accel-kitchen/dna-accessory-console/design/preview/3d-top.png

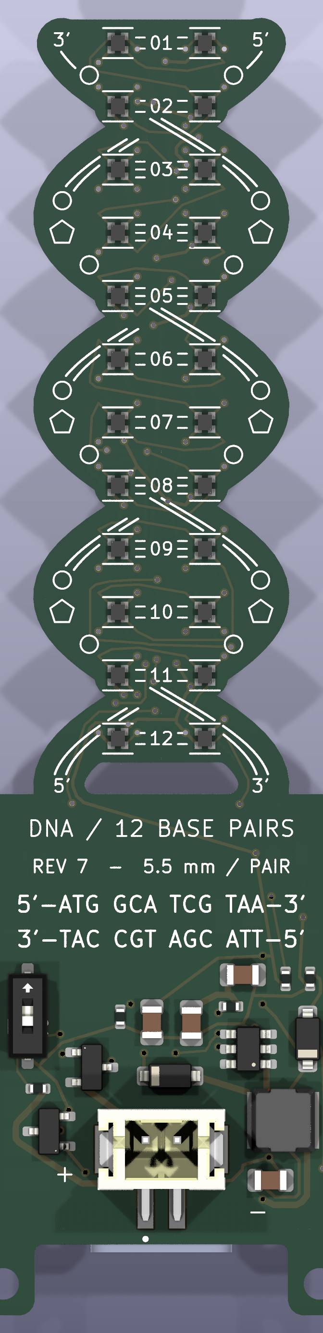
design/preview/3d-top.png
