accel-kitchen/dna-accessory-console/design/preview/3d-iso-collar-back.png

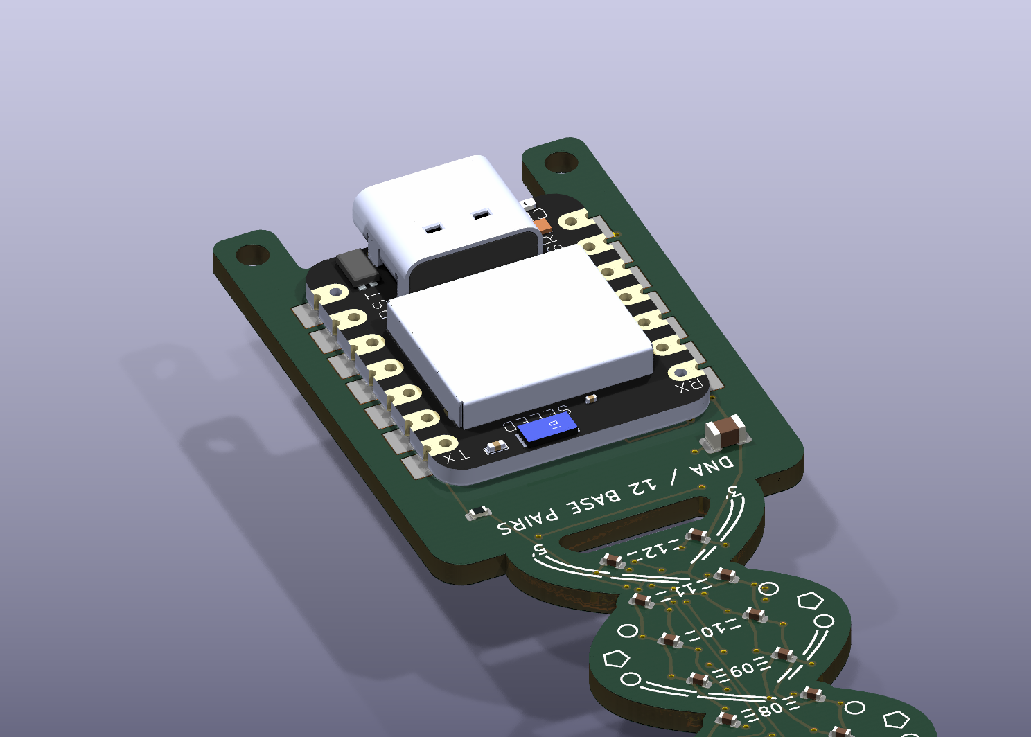
design/preview/3d-iso-collar-back.png
