accel-kitchen/dna-accessory-console/design/comparison-rev4-rev5.html

DNA / PCB — REVISION COMPARISON2026.11.05 · KiCad 9.0.4

# 旧基板より、約4割小さく。 吊り穴はマイコン側へ、 電池でも光り、 スイッチで切れる。

改訂4（配線済みの旧基板、29.0 × 116.6 mm）と改訂7（現在の基板、24.0 × 82.1 mm）を、同じ縮尺で並べて比べた資料です。 LED の並び順とデータ連鎖は変えず、外形・LED の配置・吊り穴・シルクを変え、電池でも光るように昇圧と電源切り替えの 13 部品を、電池を入り切りする電源スイッチの 3 部品とともに襟の表面に追加しました。

117 → 82 mm基板の長さ（-30%）

29 → 24 mm基板の幅（-17%）

-42%外形の面積
2,290 → 1,328 mm²

0 / 0 / 0DRC 違反・未接続・差異
新旧とも

01 / SIDE BY SIDE

## 同じ縮尺で並べる

左が旧基板、右が新基板です（表面、3D レンダリング）。らせんが短く細くなり、襟の幅が詰まり、下端に吊り穴の耳が付きました。

<b>旧</b> 改訂4 29.0 × 116.6 mm（表面）の3Dレンダリング

旧 改訂4 29.0 × 116.6 mm

→

<b>新</b> 改訂7 24.0 × 82.1 mm（表面）の3Dレンダリング

新 改訂7 24.0 × 82.1 mm

<b>旧</b> 裏面（XIAO nRF52840）（裏面）の3Dレンダリング

旧 裏面（XIAO nRF52840）

→

<b>新</b> 裏面（XIAO nRF52840）（裏面）の3Dレンダリング

新 裏面（XIAO nRF52840）

02 / OUTLINE OVERLAY

## 外形を重ねる

襟（マイコン部）の位置は同じなので、そのまま重ねられます。薄い灰色が旧、緑が新、点は LED（旧は灰色、新は黄色）です。

旧基板新基板新の LED 24 個

03 / NUMBERS

## 数値の比較

項目 | 旧（改訂4） | 新（改訂5） | 変化 | メモ
基板の幅 | 29.0 mm | 24.0 mm | -17% | マイコン部の幅を XIAO のパッドに合わせて詰めた
基板の長さ | 116.6 mm | 82.1 mm | -30% | 吊り穴の耳（4.5 mm）を含む
外形の面積 | 2,290 mm² | 1,328 mm² | -42% | 抜き穴を除いた実面積
らせん部の長さ（先端〜襟） | 88.1 mm | 49.1 mm | -44% | 旧は先端の吊り環を含む
らせんの幅 | 26.8 mm | 16.2 mm | -40% | 振幅 ×2 ＋ バックボーン幅
塩基対の LED 間隔 | 10.0 mm | 5.5 mm | -45% | 中心間。向かい合う 2 個
塩基対のピッチ | 6.5 mm | 4.0 mm | -38% | 12 対・2 回転は変わらず
バックボーン幅 / 梯子の幅 | 4.8 / 3.4 mm | 3.2 / 3.0 mm | | 梯子 3.0 mm が LED 周りのビアの限界
吊り穴 | φ3.0 mm × 1（らせん先端） | φ2.0 mm × 2（USB-C 側の耳） | | 耳の内側の間隔 16 mm
外形内の抜き穴 | 10 個 | 3 個 | | 新はらせん内の窓が消え、襟の上のスリットと吊り穴だけ
シルクの塩基文字（T/C/A/G） | 48 個 | 0 個 | | 表裏とも削除。対番号・5′3′・水素結合は残した
配線の総延長 | 1,073 mm | 846 mm | -21%
ビア | 86 個 | 107 個 | +24% | 密度が上がり、わずかに増えた
FR4 基板の重さ（概算） | 6.8 g | 3.9 g | -42% | 面積 × 1.6 mm × 1.85 g/cm³。部品・銅は含まない
部品点数 | 52 点 | 68 点 | | 新は昇圧・切り替えの 13 部品と電源スイッチの 3 部品を追加（BOM は 6 → 15 品番）
DRC（KiCad 9.0.4） | 違反 0 / 未接続 0 / 差異 0 | 違反 0 / 未接続 0 / 差異 0 | | 回路図は昇圧回路などを追加

04 / THREE CHANGES

## 変えた3点

### ① 吊り穴を、らせん先端からマイコン側へ

旧基板の先端の吊り穴

旧 らせんの先端に φ3.0 mm の穴

新基板の下端の耳と吊り穴

新 USB-C 側の下端に耳を2つ、φ2.0 mm の穴

下端の中央は USB-C の差し込み口と電池コネクタ（J1）で埋まっているため、穴は左右の耳に分けました。耳の内側の間隔は 16 mm で、USB-C のプラグはその間を通ります。 チェーンを2つの穴に通すと、USB-C 側を上にして、らせんが下に垂れます。先端の吊り環がなくなった分、らせん側も短くなりました。

### ② DNA 部分を小さく

LED 間隔を 10 mm から 5.5 mm、塩基対ピッチを 6.5 mm から 4.0 mm にし、梯子の幅を 3.4 mm から 3.0 mm に細くしました。マイコン部の幅は、XIAO のパッドが約 20 mm なので 29 mm から 24 mm まで詰めています。 配線ツールで試した限界は、ピッチ 3.8 mm で配線が収束せず、3.6 mm 以下は梯子が 2.8 mm 以下になって LED 周りのビアが入りません。

### ③ シルクの塩基文字を削除

旧基板の塩基文字つきシルク

旧 各段に T/C/A/G の文字（表裏で 48 個）

新基板のシルク

新 文字なし。対番号・水素結合・糖とリン酸の環は残す

LED の色はソフトウェアで決めるので、基板に固定の塩基文字は印刷しません。襟の配列表記（5′-ATG GCA TCG TAA-3′ など）と水素結合の本数は、そのままです。襟の表面は、昇圧部品の場所をあけるため、START/STOP と凡例 3 行を削除しました。

### ④ 電池でも光る：昇圧・電源切り替え・電源スイッチを追加

旧基板の LED の電源は XIAO の USB の 5 V だけで、電池では光りませんでした。新基板は、電池を昇圧（MT3608B で 5.0 V）して LED に供給し、USB があるときは USB を優先して自動で切り替えます（部品 13 点、襟の表面）。電池のマイナスは GND に直結し、昇圧の電流が XIAO の内部を通らないようにしました。電池は、基板上のスライドスイッチ（P-MOSFET を駆動）で入り切りでき、OFF にすると USB がないとき電池の電流は流れません（昇圧は消灯中も約 19 mA 流れるため）。詳しい確認結果は review.html にあります。

05 / NEW COLLAR

## 新しい襟まわり（3D）

襟の表面：電池コネクタ、昇圧回路、吊り穴の耳

表：電池コネクタ（J1）、電源スイッチ、昇圧回路、吊り穴の耳

襟の裏面：マイコンモジュール

裏：XIAO と USB-C。プラグは耳の間を通る

06 / UNCHANGED

## 変えていないこと

- プロジェクト設定（同一ファイル）。回路図は昇圧回路などを追加。既存の 52 部品の UUID は変更前後で一致。
- LED 24 個（12 対）、データ連鎖の順（U2 → U25）、4 コドンの区切り。console/ のピクセル順もそのまま使える。
- 既存の 52 部品の型番。配線は引き直したが、DRC は新旧とも違反 0・未接続 0・差異 0。
- 2 回転・12 塩基対のらせんの形、表裏のシルクの意匠（糖・リン酸の環、水素結合、5′/3′）。

07 / TRADE-OFFS

## 注意点

らせん内の窓（抜き穴）が消えた。ピッチを 4.0 mm にすると梯子の間が 1.0 mm で、抜きを作れません。外形のふくらみでらせんに見えますが、旧基板の「窓の開いたらせん」の見た目とは違います。

- LED が近づいたので（間隔 5.5 mm）、隣の LED の光が混ざりやすくなります。実機の見え方は未確認です。
- 耳は 4.5 mm 突き出します。USB-C のケーブルの根元（プラグ）が 16 mm より大きいと当たります。
- ビアは 86 → 107 個。配線の総延長は短くなりましたが、密度は上がっています。
- 確認したのは KiCad 上の DRC と 3D 表示までです。実機の製造・点灯・重さは未確認です。
- 発注データ（fusion/）は改訂5に合わせて再生成済みですが、Seeed Fusion への再見積・再注文はしていません。

旧：design/pre-compact-20261102/ 新：dna-accesories.kicad_pcb 生成：gen/compare_stats.py → gen/make_comparison.py
