accel-kitchen/dna-accessory-console/design/review-rev6.html

DNA / PCB — ENGINEERING REVIEW · REV. 62026.11.06 · KiCad 9.0.4

# 電池でも光る設計に。 配線と製造データは整合。

改訂6（24.0 × 82.1 mm、65 部品）は、前回（改訂5）の未解決点だった「電池だけでは LED が点灯しない」を、昇圧（MT3608B）と USB／電池の自動切り替えで解決した基板です。 KiCad の DRC・ERC に加えて、銅箔の間隔、電源の電圧降下、ネットの連鎖、部品の位置、3D 干渉、製造データを別の方法でも確かめました。

判定：回路の接続・形状・製造データに誤りは見つかりませんでした。 電池 → 昇圧（5.0 V）→ LED の経路と、USB があるときは USB を優先する切り替えは、回路・基板・配線で確認できました。 ただし、追加した昇圧回路は実機で動かしていません。確認をおすすめするのは、昇圧部品の調達（型番と在庫）、電池の仕様と電流、昇圧の GND の戻り経路（0.2 mm 幅）、吊り穴まわりの肉厚、ビアの環です。実機の製造・点灯・Fusion の受入れ確認は、まだ行っていません。

改訂6の表面

改訂6の裏面

0 / 0 / 0DRC：違反・未接続・回路図との差異
ERC は警告 3 件（下記）

0.14 mm銅箔どうしの最小間隔の実測
Fusion の下限 0.10 mm

104 mV全白（368 mA）時の最遠 LED の電源損失
昇圧出力からの往復

4.8〜5.2 V昇圧の出力電圧の範囲（公称 5.0 V）
LED の動作 2.5〜5.5 V

01 / WILL IT LIGHT?

## 「ちゃんと動くか」の判定

条件 | 判定 | 根拠と限界
USB で給電して LED を点灯 | 設計上は成立 | USB の 5 V → D2（ショットキー）→ POWER。Q1 が昇圧を止めるので電池は減らない。ダイオードの順電圧（約 0.4 V と見積り）を引いて LED は約 4.5 V。配線の損失は最遠 LED で 98 mV。実機は未確認。
電池だけで LED を点灯 | 設計上は成立 | 電池（VBAT）→ L1 → MT3608B → D1 → POWER（5.0 V）。出力電圧は帰還抵抗 110 kΩ／15 kΩ で決まり、部品の公差を入れて 4.81〜5.19 V。実機での起動・出力は未確認。
USB を抜く・挿す瞬間 | 要確認 | USB を抜くと Q1 が切れて昇圧が起動する。起動までの間は、昇圧の IC を通らず電池からインダクタとダイオード経由で LED に約 3.4 V が届く。LED が一瞬暗くなる、または再起動する可能性がある。USB を挿すと Q1 が EN を落とし、USB 経由に切り替わる。
電池をつないだまま USB で給電（充電） | 設計上は成立 | J1 → VBAT → XIAO の BAT+（ネット一致を確認）。充電は XIAO の機能で、昇圧とは別の経路。電池の極性・仕様は未確認。
XIAO D6 → 24 個の LED を順に制御 | 配線は成立 | D6 → R1（100 Ω）→ U2.DIN → … → U25 の 23 段をネットで確認。ファームウェアは未コンパイル・未書き込み（USB 給電のときだけ動く処理は削除済み）。
3.3 V の信号を LED が読めるか | 条件付き | LED 資料 p.5：VDD=5 V での入力 High は 2.8 V 以上、Low は 1.6 V 以下。XIAO の 3.3 V は上回る。昇圧の出力が 4.8 V 台でも条件は近い。実波形は未測定。
Bluetooth（BLE） | 未確認 | XIAO の周囲の銅箔・昇圧のスイッチングとアンテナの位置関係は要確認（R6-06）。コンソールは USB シリアルを使うので、LED 点灯には影響しない。
Seeed Fusion での製造・組立 | 見込みは良好 | 実測の余裕は公開仕様を満たす。ビアの環だけ規定を確認できなかった（R5-03）。昇圧部品の調達は未確認（R6-01）。Fusion の DFM 確認は未実施。

02 / FINDINGS

## 指摘

「要判断」は設計仕様の決めが必要なもの、「要確認」は実部品・製造先・実機で確かめるもの、「参考」は知っておけばよいものです。今回は要判断がなくなり、昇圧回路に関する要確認が新しく加わりました。

R6-01 ／ 要確認 ／ 改訂6で追加

### 昇圧回路は実機で動かしていない。部品の調達も未確認

追加した 13 部品（MT3608B、10 µH インダクタ、ショットキー 2 個、MOSFET、10 µF ×4、抵抗 ×4）は、データシートの標準回路（Fig.1：5 V 出力、110 kΩ／15 kΩ）に沿って選び、定格の余裕を計算しました。 入力電流の最大（全白・3.0 V の電池）は約 0.73 A で、インダクタの実効電流 1.2 A、飽和電流 1.3 A、ダイオード 1 A、MT3608B のスイッチ電流制限 4 A のいずれにも収まります。出力コンデンサは合計 30 µF（公称）で、データシートの推奨 22 µF 以上です。

確認が必要なのは次の点です。①起動・5 V 出力・切り替え・効率・発熱・ノイズは、実機で測るまで分かりません。②MT3608B の LCSC 番号、Bourns SRN4018TA-100M の LCSC 番号、抵抗（110 kΩ、15 kΩ、100 kΩ）の LCSC 番号は確認できていません（BOM のリンクは検索ページ）。Fusion が調達できない場合の代替品は fusion/BOM_detail.xlsx に書きました。③インダクタの代替（Sunlord SWPA4020S100MT）は、パッド寸法を確認してから使ってください。

根拠：MT3608B データシート Rev1.1（Aerosemi、取得日 2026-11-06）、Bourns SRN4018TA-100M の仕様（販売店の掲載値）、ネットリスト。部品の入手性は検索結果の範囲です。

R6-02 ／ 要確認 ／ 前回の指摘 07（電池の仕様）に対応

### 電池の仕様と、電池から流れる電流

全白（LED 24 個で 0.37 A、5 V）のとき、電池から流れる電流は 3.7 V で約 0.58 A、3.0 V で約 0.73 A です（昇圧の効率 85 % の仮定）。ファームウェアの明るさ上限（128/255）では約半分です。 容量 500 mAh の電池なら、全白で約 0.9 時間、上限どおりで約 1.7 時間の見積りです（概算で、実測ではありません）。容量が小さい電池（150 mAh 以下）は、全白で 4C 前後になるので避けてください。

電池は保護回路付きの 1 セル（3.7 V）を使ってください。MT3608B は入力 2.4 V 付近で止まりますが、電池の過放電を防ぐ回路は基板にありません。J1 の 1 番ピン（基板の「+」側）が電池の＋です。JST PH の電池ケーブルは売り場によって赤黒の並びが逆の場合があるので、実物の極性を確かめずにつなぐと、XIAO や電池を壊すことがあります。

R6-03 ／ 要確認 ／ 改訂6で追加

### 昇圧の GND の戻り経路が 0.2 mm 幅で、許容電流に近い

基板には GND の面（ベタ）がなく、GND は 0.2 mm 幅の配線です。昇圧の入力電流が電池へ戻る経路は、全白・3.0 V の電池で最大 0.73 A が、幅 0.2 mm の銅箔を通ります。同じ幅の外層の許容電流は、温度上昇 10 K で約 0.74 A（IPC-2221）で、ほぼ同じ値です。 ファームウェアの明るさ上限（128/255）では約 0.36 A、3.7 V の電池の全白でも約 0.58 A なので、実用上は余裕がありますが、全白を長く続けるとこの経路が温まります。

昇圧の大電流の線（VBAT、SW）は 0.4 mm 幅で引きました（VBAT の最大電流 0.73 A）。スイッチ端子（SW）の配線は 4.4 mm と短くまとまっています。 改善案：GND を 0.4 mm 以上にする、または襟の部分に GND の銅箔（ベタ）を追加する。データシートも「強い GND 面」を勧めています。

R6-04 ／ 参考 ／ 前提の確認

### 電池のマイナス（BAT−）を GND に直結した

昇圧の入力電流を XIAO の内部経由で戻さないため、J1 の 2 番ピンと XIAO の BAT−パッドを、基板上で GND につなぎました。Seeed の XIAO nRF52840 回路図（v1.1）では、電池は VBAT と GND だけで、BAT− は GND そのものです。この前提は回路図で確認しましたが、実物のモジュールでの導通は測っていません。 ERC は、電池の＋と電源フラグ、BAT− と GND の端子の型の組み合わせについて警告を出します（意図した接続です）。

R5-02 ／ 要確認 ／ 改訂5で生じた点

### 吊り穴まわりの肉厚が 1.0 mm

吊り穴は φ2.0 mm の穴 2 つで、耳（幅 4 mm、先端 y=150.5 mm）の穴の縁から外形までが 0.98 mm です（FR4 厚 1.6 mm）。改訂4の穴（φ3.0 mm）は先端の周りが約 2.1 mm ありました。

概算：ペンダントを約 10 g、動いたときの衝撃を 10 倍（1 N）とし、耳の先端がちぎれる面（穴の縁から外形まで 1.0 mm、2 面、厚 1.6 mm の合計 3.2 mm²）に FR4 のせん断強度を 40 MPa（一般的な値の仮定）とすると、耐えられる力は約 130 N で、安全率は約 100 です。静的な強度は足りる見積りですが、 金属のチェーンや指輪で縁がこすれて削れる、落とした衝撃で耳が欠ける、といった使い方の面では余裕が小さい部分です。気になる場合は、耳を 6 mm 幅にして穴の縁から 1.5 mm 以上取る方法があります。

根拠：外形データ（design/dna-geometry.json）からの実測。強度は概算で、実物の試験はありません。穴の円は外形層の 128 角形で出力されます（Fusion の DFM で問題にならないか、発注時に確認してください）。

R5-03 ／ 要確認 ／ 製造

### ビアの環が 0.13 mm

ビアはパッド 0.56 mm・穴 0.30 mm で、環（穴の縁からパッドの縁まで）は 0.13 mm、91 個すべて同じです。Seeed Fusion の公開ページ（製造仕様の wiki・製品ページ）では、最小穴径 0.2 mm は読み取れましたが、環やビアのパッド径の規定は見つかりませんでした。 古い資料に 0.15 mm 以上という記載があるという情報もありますが、現行の値とは確認できていません。

対応：発注時に Fusion の DFM 確認を受けてください。0.15 mm が必要と言われた場合は、ビアのパッドを 0.60 mm にして配線をやり直します（ルーターの設定 VIAD と gen/route_apply.py のビア径を変えて再配線します。ただし、間隔の余裕は減ります）。

R6-06 ／ 参考（前回の R5-05 を更新）

### XIAO のアンテナ側に配線の銅箔と昇圧回路がある

XIAO の上端（らせんに向く側、モジュールの端は y=124 mm）を含む帯（x 90〜110、y 121〜129 mm）に、41 mm 分の配線があります。さらに、昇圧回路は襟の表面（y 127〜141 mm）にあり、1.2 MHz で動くスイッチ部（インダクタとダイオード）はアンテナ側の端（y=124 mm）から約 4〜11 mm の位置です（L1 の端が 4 mm、D1 が 8 mm）。 アンテナの位置と銅箔の禁止範囲は Seeed の資料で確認していません。BLE を使うときは、昇圧が動いている状態で通信距離を実測してください。

R6-07 ／ 参考

### シルク・LED 間隔・USB の電流

- 襟のシルクは、昇圧部品の場所をあけるため、START/STOP と凡例 3 行（A=T 2 BONDS…、2 TURNS…、WATSON CRICK…）を削除し、REV の表記を「REV 6」にしました。「+」「−」は J1 のそばに移しました。
- LED の枠線 8 本の端が、外形に 0.08〜0.2 mm まで近づいています（DRC は警告扱い）。製造の外形の公差（±0.2 mm）で、端がわずかに欠ける可能性があります。
- LED 間隔が 5.5 mm なので、隣の LED の光が混ざりやすくなります。らせん内の窓は消えて、襟の上のスリットだけです。
- USB で給電するときは、LED 全白の 0.37 A に XIAO と電池の充電（最大 100 mA）が加わり、約 0.48 A で USB の 0.5 A に近づきます。ファームウェアの明るさ上限（128/255）では約 0.19 A です。

R6-08 ／ 参考 ／ 資料の食い違い（今回修正）

### 文書の更新

- 旧 review.html（改訂5）は design/review-rev5.html に、さらに前のレビューは design/review-rev3-rev4.html にあります。
- lp/（試作ページ）、console/README.md、2 つのファームウェアの冒頭、fusion/README.md、design/README.md を、電池でも光る構成に合わせて更新しました。

03 / CARRY-OVER

## 前回（改訂3）の指摘 01〜09 の結果

前回の指摘 | 現在 | 根拠
01 LED の VDD と DOUT が逆 | 解決 | パッド 1=DOUT（左上）、2=VDD（右上）、3=GND（左下）、4=DIN（右下）。LED 資料 p.10 の上面図と一致。パッドの機能（ネット）は全 24 個で確認。座標は U2・U3 で確認（全 LED が同じフットプリントで、向きは 0°/180° のみ）。
02 電源・GND・24 段の信号を配線 | 解決 | DRC 未接続 0。ネットの連鎖を基板上で確認（下の一覧）。
03 電池単独の LED 給電 | 解決（設計・実装） | 昇圧（MT3608B）と USB／電池の自動切り替えを追加。実機は未確認（R6-01）。
04 LED 近傍のコンデンサ | 解決 | C1〜C24（100 nF）が各 LED の真裏、C25（10 µF）が入口。LED のパッド〜コンデンサ間の銅箔の長さは平均 3.9 mm、最大 4.6 mm（GND 側 最大 4.0 mm）。
05 3.3 V の信号 | 条件付き | 100 Ω の直列抵抗 R1 を実装。しきい値は満たす見込み。実波形は未測定。
06 ファームウェア | コードあり・未検証 | D6・24 個・GRB・明るさ上限 128。電池でも動くよう、USB 給電のときだけ動く処理を削除。未コンパイル・未書き込み。
07 XIAO 裏面実装と電池 | 一部 | U1 は裏面の底面パッドで実装する前提。電池の仕様と極性は → R6-02。
08 ERC と製造ルール | 一部 | ERC は警告 3 件（ラベル 1、端子の型の組み合わせ 2）。DRC の規則は最小間隔・最小線幅が 0 のままだが、実測と Fusion 公開仕様を比較して余裕を確認した（下の表）。
09 USB-C プラグの干渉 | 解決 | USB-C の差込口は y=146.51 mm で基板端（146.0）より外。プラグ外形（規格上限 12.35 × 6.5 mm）と基板の重なり 0.0 mm³。耳の内側の間隔 16 mm、片側の余裕 1.83 mm。

04 / MEASUREMENTS

## 製造に対する余裕の実測

DRC の規則が 0 のままだと「違反 0」は余裕を表しません。そこで、一時的に厳しい規則（間隔 1.0 mm 以上など）を KiCad に与え、違反の「実測値」の最小を集めました。Fusion の値は 2026-11-06 に公式ページ（製造仕様の wiki、製品ページ）で読んだものです。

項目 | この基板の実測 | Fusion の公開仕様 | 余裕 | 判定
銅箔どうしの最小間隔（別ネット） | 0.143 mm | 0.102 mm（4 mil） | 約1.4倍 | 余裕あり
最小線幅（信号／電源・GND／昇圧の大電流） | 0.15 ／ 0.20 ／ 0.40 mm | 0.102 mm（4 mil） | 約1.5倍以上 | 余裕あり
銅箔〜基板外形（穴を含む） | 0.560 mm | 0.3 mm 以上（このプロジェクトの規則は 0.5 mm） | 約1.9倍 | 余裕あり
LED パッドの間（ソルダーマスクのダム） | 0.39 mm | 0.32 mm 以上（緑・通常）／0.35 mm 以上（他色） | 1.1〜1.2倍 | 足りる
ビア（パッド／穴／環） | 0.56 ／ 0.30 ／ 0.13 mm | 最小穴 0.2 mm。環・パッド径の規定は公開ページで確認できず | — | 要確認
ビア穴の縁どうし／穴〜銅箔 | 0.29 ／ 0.273 mm | 規定は公開ページで確認できず（このプロジェクトの規則は 0.25 mm） | — | 要確認
シルク（線幅／文字高さ） | 0.12〜0.15 ／ 0.8 mm | 線幅 0.10 mm（4 mil）以上、文字高さ 0.58 mm（23 mil）以上 | 約1.2〜1.4倍 | 足りる
外形内の穴・抜き（吊り穴φ2.0 mm、襟上のスリット） | 最小幅 2.0 mm | 非メッキのスロット 0.8 mm 以上 | 2.5倍 | 余裕あり
基板サイズ | 24.0 × 82.1 mm | 10 × 10 〜 500 × 500 mm | — | 範囲内

ビアは表裏とも被覆（テンティング）の設定です。外形の穴は 128 角形の外形線で出力されます。製造先の最終確認は、発注時の Fusion の DFM 確認によります。

05 / POWER

## 電源

### LED までの電圧降下（基板の銅箔から計算）

基板の実際のトラックとビアから抵抗網を作り（銅 35 µm、0.49 mΩ/□、ビア 1.1 mΩ）、電源の出口（電池動作は D1 のカソードと昇圧の GND、USB 動作は D2 のカソードと XIAO の GND）から各 LED のパッドまでの電位差を計算しました。LED は定電流（R・G・B 各 5 mA）なので、全白でも 1 個あたり約 15.35 mA です。

負荷 | 動作 | 電源側の最大降下 | GND 側の最大上昇 | 最も損失の大きい LED（U3）
全白 15.35 mA／個（368 mA） | 電池 | 45 mV | 59 mV | 104 mV
全白 15.35 mA／個（368 mA） | USB | 44 mV | 55 mV | 98 mV
2 倍の余裕 30 mA／個（720 mA） | 電池 | 89 mV | 115 mV | 202 mV

### 電池から昇圧までの経路

電池の電圧 | 電池から流れる電流（概算） | 電池 → インダクタ（VBAT）の降下 | 昇圧の GND → 電池の降下
3.7 V | 0.58 A | 10 mV | 19 mV
3.0 V（空に近い） | 0.73 A | 13 mV | 24 mV

- LED の動作電圧は 2.5〜5.5 V（資料 p.5）。昇圧の出力は 4.81〜5.19 V、配線の損失は 0.1〜0.2 V なので問題ありません（USB 動作では D2 の順電圧で約 4.5 V）。この昇圧は、電池の電圧が下がっても 5 V 近くを保つので、LED の色（A/T/G/C の識別色）が電池の残量で変わりません。
- 各配線の最大電流：電源の本線 0.37 A（幅 0.2 mm）、LED の GND 戻り 0.37 A（幅 0.2 mm）、電池〜インダクタ 0.73 A（幅 0.4 mm）、昇圧の GND 戻り 0.73 A（幅 0.2 mm → R6-03）。0.2 mm 幅の許容電流は約 0.74 A（10 K 上昇、IPC-2221）。
- この計算は直流で、銅箔の温度・接触抵抗・昇圧のスイッチング（1.2 MHz）の影響・XIAO の USB 5 V 経路の降下は含みません。実機の測定が必要です。

06 / NETS & FILES

## ネット・部品・製造データの整合

### 基板上のネットの確認（KiCad の基板データから）

- ✔ R1.2 -> U2.DIN
- ✔ U1.D6 -> R1.1
- ✔ U(n).DOUT -> U(n+1).DIN, 23 hops
- ✔ U25.DOUT unconnected (CODON_END)
- ✔ every LED pad 2 = POWER, pad 3 = GND
- ✔ C(n-1) POWER/GND under U(n), same centre, back side
- ✔ POWER pads = 54: 24 LED VDD + C1-C25, C27, C29 + D1.K, D2.K, R2.1 (U1 is not on it)
- ✔ GND pads = 60: 24 LED + C1-C29 + U1 GND/BAT-, J1.2, U26, Q1.S, R3, R5
- ✔ VUSB = U1.VUSB, D2.A, Q1.G, R5.1
- ✔ VBAT = J1.1, U1.BAT+, U26.IN, L1.1, R4.1, C26.1, C28.1
- ✔ SW = U26.SW, L1.2, D1.A
- ✔ BOOST_EN = U26.EN, Q1.D, R4.2
- ✔ FB = U26.FB, R2.2, R3.1
- ✔ feedback divider R2 110k / R3 15k: output = 0.6 V x (1 + R2/R3) = 5.00 V
- ✔ every footprint value matches the schematic part (U26 MT3608B, L1 10uH, D1/D2 1N5819HW, Q1 2N7002)
- ✔ battery return: J1.2 and U1.BAT- are on GND (BAT- is the XIAO GND)
- ✔ U1 is not connected to POWER (LED power only through D1 / D2)

### 改訂5から変えたこと・変えていないこと

- 追加：昇圧と電源切り替えの 13 部品（表面の襟）、電池のマイナスの GND 直結、シルクの整理。
- 変えていない：らせんの形（24.0 × 82.09 mm）、LED 24 個とコンデンサ 24 個の位置・向き・面、U1・J1・R1・C25 の位置、LED のデータ連鎖（U2 → U25）。
- 回路図を更新（部品 13 点とネットの追加、U1.VUSB のネット名を POWER から VUSB へ、電池の＋を VBAT へ）。部品の UUID は、既存の 52 個で変更なし。

### 製造データ（fusion/）

- ガーバー・ドリル・実装座標を現在の基板から作り直した。外形サイズ 24.05 × 82.14 mm（ガーバーのジョブ情報）。
- ドリルは φ0.30 mm のみで 91 箇所＝基板のビアの数と一致。穴あけ（NPTH）はなし。
- BOM は 13 行・65 点、実装座標は 65 行で、基板の座標・面と 0.01 mm 以内で一致（不一致 0 件）。実装図に昇圧部の拡大図（Detail E）を追加。
- コンソールの LED 座標（console/board-data.js）は base-pairs.csv と一致。

### 3D 干渉

- 全 65 部品の STEP で、部品どうし・部品と基板の衝突は 0 件。
- XIAO の USB-C の口は基板端から 0.51 mm 外。USB-C プラグの外形（規格上限）と基板（耳を含む）の重なりは 0。

07 / NOT VERIFIED

## 確認していないこと

- 昇圧回路の動作（起動、5 V の出力、負荷変動、USB の抜き差しでの切り替え、効率、発熱、スイッチングのノイズ）。
- 実際の基板の製造、はんだ付け、通電、LED の点灯、温度、電池での持続時間、BLE の通信距離、ペンダントとしての重さ・つり合い。
- ファームウェアのコンパイル、書き込み、コンソールとの実機接続。
- 昇圧部品の調達（MT3608B、インダクタ、抵抗の LCSC 番号と在庫）と、インダクタ代替品のパッド寸法。
- Seeed Fusion の DFM 確認・見積・受入れ（ビアの環、穴・ビアの間隔、組立の部品間隔、基準マーク、XIAO を裏面に実装する工程は、公開ページで規定を確認できませんでした）。
- XIAO の底面パッド・アンテナ・充電の仕様の最新版との照合（Seeed の回路図は v1.1 を使用）。BAT− が GND であることの実物での導通確認。
- LED の最大定格・実際の購入ロットの仕様（資料は XINGLIGHT の公開データシート）。
- 耳の強度は概算で、実物の引っ張りや衝撃の試験はありません。

測定・生成：gen/review_checks.py（抵抗網・ネット・位置）、gen/check_interference.py（3D 干渉）、厳しい規則の DRC（gen/_runs/strict_summary.json）、gen/make_review.py。 旧レビュー：design/review-rev5.html、design/review-rev3-rev4.html 比較資料：design/comparison-rev4-rev5.html Fusion 公開仕様：seeedstudio.com の製造仕様 wiki と Fusion PCB のページ。 MT3608B：Aerosemi データシート Rev1.1。
