accel-kitchen/dna-accessory-console/design/revision-01/review.html

DNA / PCB · LAYOUT REVISION 01 · 2026.10.08

# 2本の鎖、12組の塩基対。

1個のLEDを1個の塩基として、24個を左右の鎖に12対で配置しました。各対は連続するLED番号でつながり、交差位置では鎖とLEDの左右が入れ替わります。

書き込み確認：成功 — 作成・読み戻し・削除を確認してから元設計をバックアップし、主PCBファイルを更新しました。

実座標に基づく配置図。LEDの黄／青は鎖の識別用で、塩基種・発光色の指定ではありません。XIAOは裏面です。実際のシルクはKiCad出力図を参照。

12塩基対

24RGB LED

29×117外形寸法 / 約mm

## 変更した形状と配置

- 外形を2本のらせん状の鎖と12本の塩基対の横棒で構成する、連続した1枚の基板へ再設計。
- 横棒の両端に1個ずつLEDを配置し、U2/U3からU24/U25まで12組に対応。
- LED間隔をらせんの投影形状に合わせて変化させ、鎖の交差に沿って左右を反転。
- 下端に裏面のXIAOと表面のJ1をまとめ、上端に直径3 mmの吊り下げ穴を追加。
- 小さな切抜き片を除き、内部スロットの角を約0.6 mm半径で丸める。
- LED番号は組立図に、塩基対番号01〜12は基板シルクに記載。

装飾用の2回転モデルです。塩基対数／1回転の比率や寸法は分子スケールを再現していません。

## 回路図との対応

U1.D6 → U2 → U3 → … → U25
部品UUID、パッド番号、全ネット名を維持しています。各ペア内のDOUT→DINを12本配線済みです。3対＝6個のLEDが元のCODON区分1組に対応します。

対 | 鎖A | 鎖B | 区分 | Y / mm
01 | U2 | U3 | 1 | 40.0
02 | U4 | U5 | 1 | 46.5
03 | U6 | U7 | 1 | 53.0
04 | U8 | U9 | 2 | 59.5
05 | U10 | U11 | 2 | 66.0
06 | U12 | U13 | 2 | 72.5
07 | U14 | U15 | 3 | 79.0
08 | U16 | U17 | 3 | 85.5
09 | U18 | U19 | 3 | 92.0
10 | U20 | U21 | 4 | 98.5
11 | U22 | U23 | 4 | 105.0
12 | U24 | U25 | 4 | 111.5

## 配置段階の検証

- KiCad 9.0.4：外形、銅箔と基板端、シルク、ライブラリ一致等の違反 0件。
- 回路図との対応差異 0件。
- 全26個のフットプリントとパッドネットの対応を更新前後で比較。
- 基板外のLED配置を解消し、単一外周と内部切抜きに整理。

この版は外形・配置の改訂版です。
未接続は62件あります。電源・GND、対と対の間、XIAO・電池端子の配線は次工程です。電池単独でのLED給電、デカップリング、採用LEDの1番／2番端子対応は前回のレビューから継続する設計課題で、今回の配置変更では解決していません。製造・点灯試験用の完成版ではありません。

## 設計ファイル

KiCad PCB回路図表面のKiCad出力裏面のKiCad出力塩基対一覧DRC結果改訂前レビュー

元ファイルのバックアップ：design/pre-redesign-20261008/ · 再生成用スクリプト：gen/ · 最小幅・厚さ・材質・色等の製造条件は別途確定。
