accel-kitchen/dna-accessory-console/design/base-pairs.csv

pair | group | strand | base | reference | x_mm | y_mm | rotation_deg | DIN | DOUT
1 | 1 | A | A | U2 | 102.75 | 70.0 | 180 | DIN_FIRST | Net-(U2-DOUT)
1 | 1 | B | T | U3 | 97.25 | 70.0 | 0 | Net-(U2-DOUT) | Net-(U3-DOUT)
2 | 1 | A | T | U4 | 102.75 | 74.0 | 180 | Net-(U3-DOUT) | Net-(U4-DOUT)
2 | 1 | B | A | U5 | 97.25 | 74.0 | 0 | Net-(U4-DOUT) | Net-(U5-DOUT)
3 | 1 | A | G | U6 | 97.25 | 78.0 | 0 | Net-(U5-DOUT) | Net-(U6-DOUT)
3 | 1 | B | C | U7 | 102.75 | 78.0 | 180 | Net-(U6-DOUT) | CODON2
4 | 2 | A | G | U8 | 97.25 | 82.0 | 0 | CODON2 | Net-(U8-DOUT)
4 | 2 | B | C | U9 | 102.75 | 82.0 | 180 | Net-(U8-DOUT) | Net-(U10-DIN)
5 | 2 | A | C | U10 | 97.25 | 86.0 | 0 | Net-(U10-DIN) | Net-(U10-DOUT)
5 | 2 | B | G | U11 | 102.75 | 86.0 | 180 | Net-(U10-DOUT) | Net-(U11-DOUT)
6 | 2 | A | A | U12 | 102.75 | 90.0 | 180 | Net-(U11-DOUT) | Net-(U12-DOUT)
6 | 2 | B | T | U13 | 97.25 | 90.0 | 0 | Net-(U12-DOUT) | CODON3
7 | 3 | A | T | U14 | 102.75 | 94.0 | 180 | CODON3 | Net-(U14-DOUT)
7 | 3 | B | A | U15 | 97.25 | 94.0 | 0 | Net-(U14-DOUT) | Net-(U15-DOUT)
8 | 3 | A | C | U16 | 102.75 | 98.0 | 180 | Net-(U15-DOUT) | Net-(U16-DOUT)
8 | 3 | B | G | U17 | 97.25 | 98.0 | 0 | Net-(U16-DOUT) | Net-(U17-DOUT)
9 | 3 | A | G | U18 | 97.25 | 102.0 | 0 | Net-(U17-DOUT) | Net-(U18-DOUT)
9 | 3 | B | C | U19 | 102.75 | 102.0 | 180 | Net-(U18-DOUT) | CODON4
10 | 4 | A | T | U20 | 97.25 | 106.0 | 0 | CODON4 | Net-(U20-DOUT)
10 | 4 | B | A | U21 | 102.75 | 106.0 | 180 | Net-(U20-DOUT) | Net-(U21-DOUT)
11 | 4 | A | A | U22 | 97.25 | 110.0 | 0 | Net-(U21-DOUT) | Net-(U22-DOUT)
11 | 4 | B | T | U23 | 102.75 | 110.0 | 180 | Net-(U22-DOUT) | Net-(U23-DOUT)
12 | 4 | A | A | U24 | 102.75 | 114.0 | 180 | Net-(U23-DOUT) | Net-(U24-DOUT)
12 | 4 | B | T | U25 | 97.25 | 114.0 | 0 | Net-(U24-DOUT) | CODON_END
