accel-kitchen/dna-accessory-console/design/revision-01/base-pairs.csv

pair | group | strand | reference | x_mm | y_mm | rotation_deg | DIN | DOUT
1 | 1 | A | U2 | 110.62518 | 40.0 | 180 | CODON_START | Net-(U2-DOUT)
1 | 1 | B | U3 | 89.37482 | 40.0 | 0 | Net-(U2-DOUT) | Net-(U3-DOUT)
2 | 1 | A | U4 | 102.84701 | 46.5 | 180 | Net-(U3-DOUT) | Net-(U4-DOUT)
2 | 1 | B | U5 | 97.15299 | 46.5 | 0 | Net-(U4-DOUT) | Net-(U5-DOUT)
3 | 1 | A | U6 | 92.22183 | 53.0 | 0 | Net-(U5-DOUT) | Net-(U6-DOUT)
3 | 1 | B | U7 | 107.77817 | 53.0 | 180 | Net-(U6-DOUT) | CODON2
4 | 2 | A | U8 | 89.37482 | 59.5 | 0 | CODON2 | Net-(U8-DOUT)
4 | 2 | B | U9 | 110.62518 | 59.5 | 180 | Net-(U8-DOUT) | Net-(U10-DIN)
5 | 2 | A | U10 | 97.15299 | 66.0 | 0 | Net-(U10-DIN) | Net-(U10-DOUT)
5 | 2 | B | U11 | 102.84701 | 66.0 | 180 | Net-(U10-DOUT) | Net-(U11-DOUT)
6 | 2 | A | U12 | 107.77817 | 72.5 | 180 | Net-(U11-DOUT) | Net-(U12-DOUT)
6 | 2 | B | U13 | 92.22183 | 72.5 | 0 | Net-(U12-DOUT) | CODON3
7 | 3 | A | U14 | 110.62518 | 79.0 | 180 | CODON3 | Net-(U14-DOUT)
7 | 3 | B | U15 | 89.37482 | 79.0 | 0 | Net-(U14-DOUT) | Net-(U15-DOUT)
8 | 3 | A | U16 | 102.84701 | 85.5 | 180 | Net-(U15-DOUT) | Net-(U16-DOUT)
8 | 3 | B | U17 | 97.15299 | 85.5 | 0 | Net-(U16-DOUT) | Net-(U17-DOUT)
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
