accel-kitchen/dna-accessory-console/design/functional-review/review-desktop-top.png

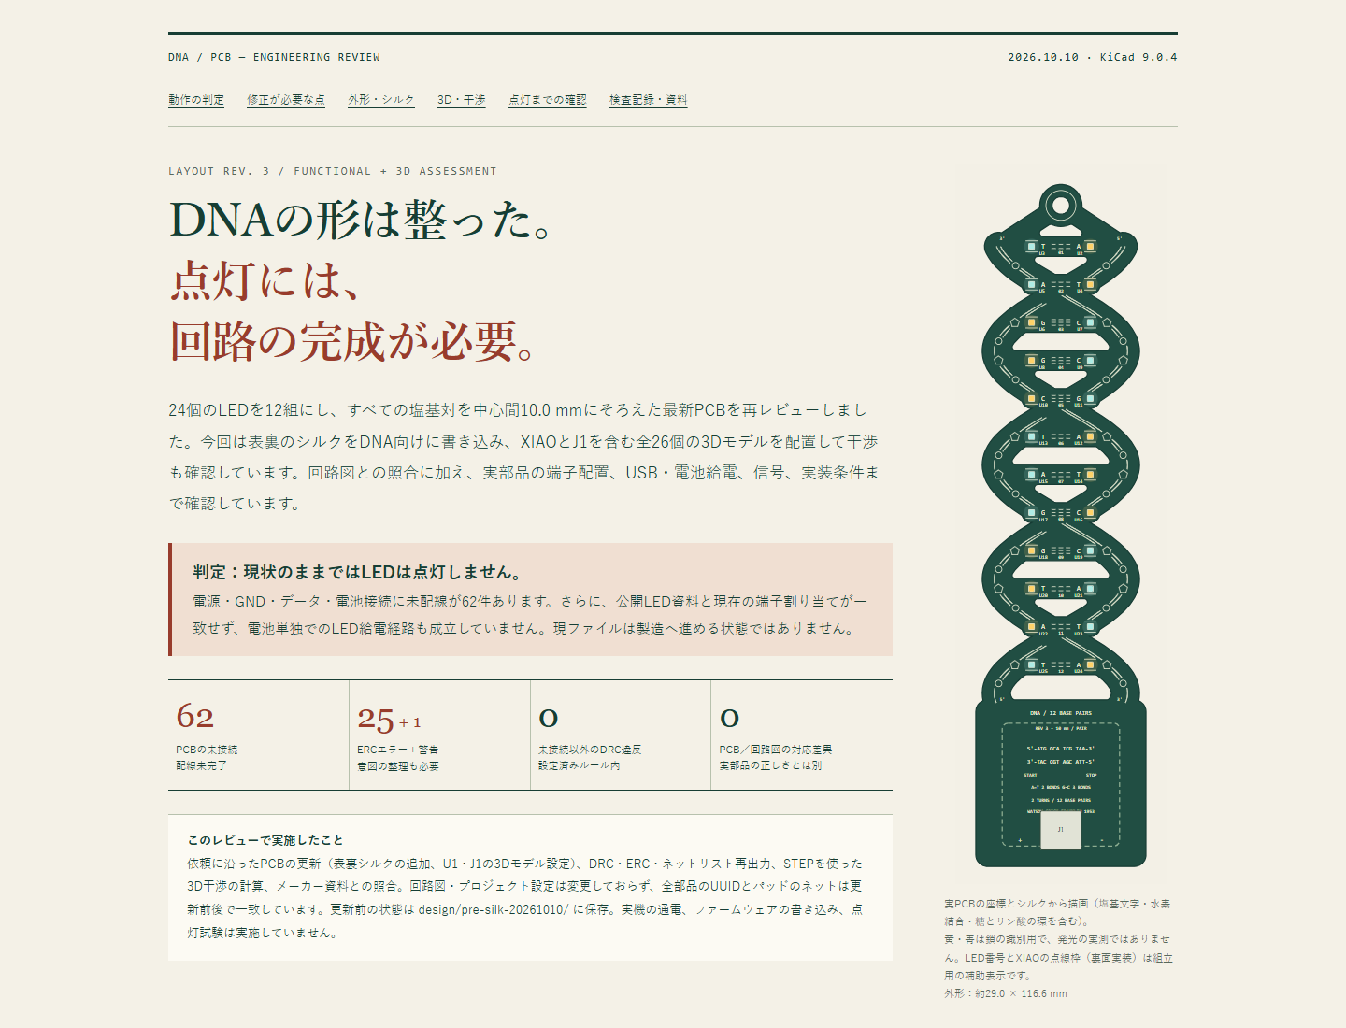
design/functional-review/review-desktop-top.png
