accel-kitchen/dna-accessory-console/design/functional-review/review-desktop.png

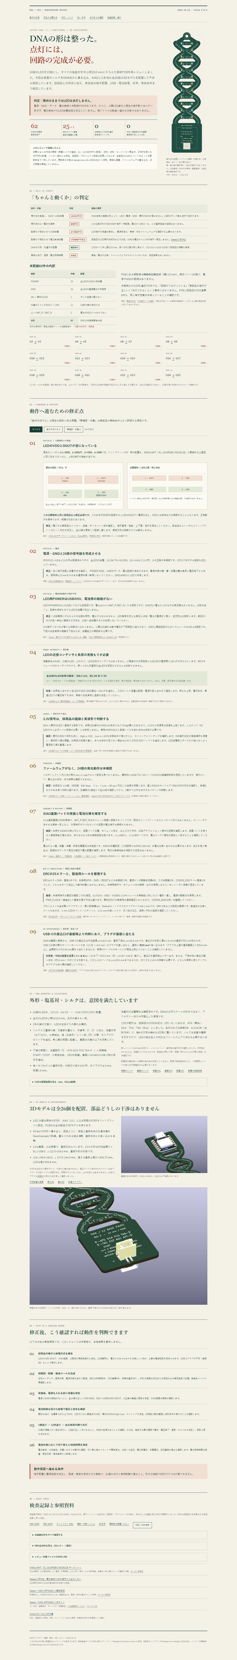
design/functional-review/review-desktop.png
