accel-kitchen/dna-accessory-console/design/functional-review/review-mobile-top.png

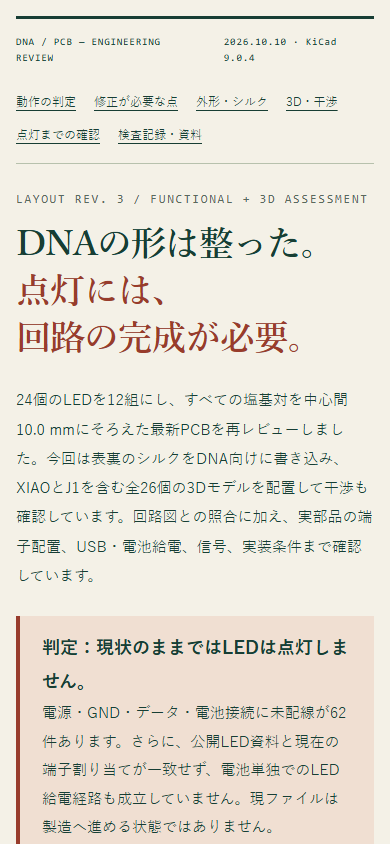
design/functional-review/review-mobile-top.png
