accel-kitchen/dna-accessory-console/design/functional-review/review-mobile.png

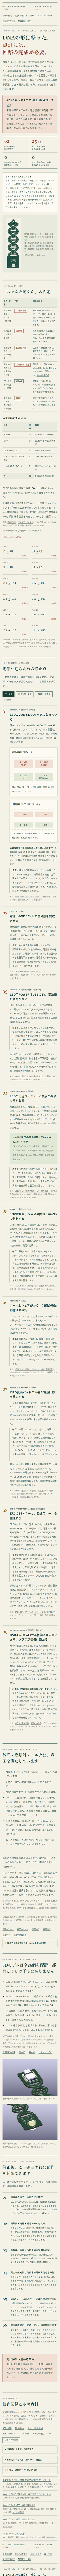
design/functional-review/review-mobile.png
