accel-kitchen/dna-accessory-console/design/functional-review/review-pinout.png

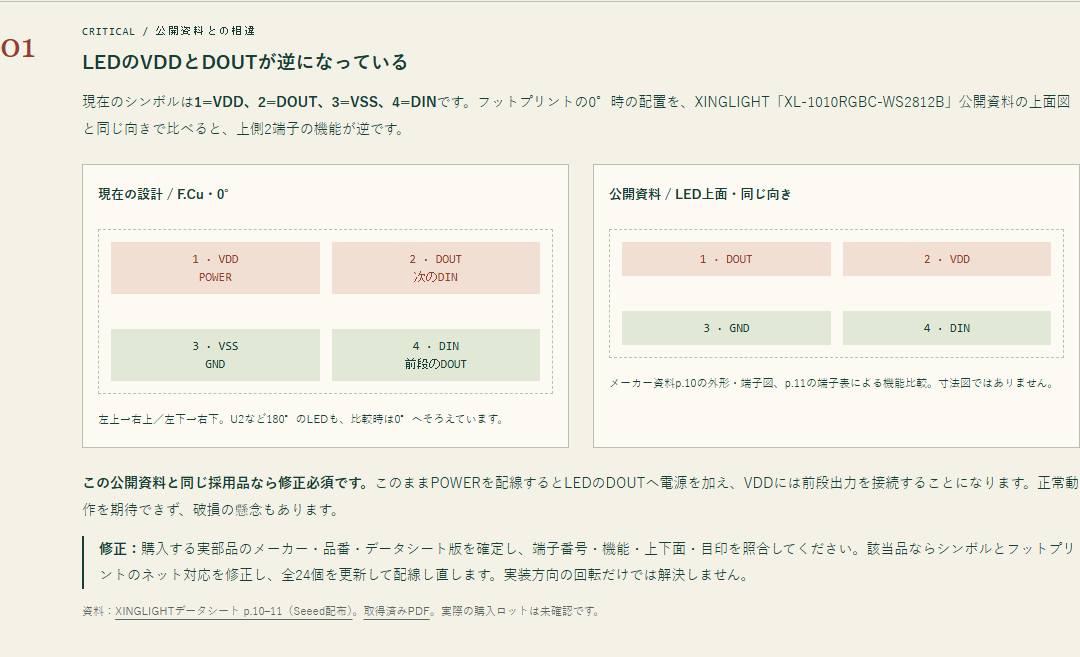
design/functional-review/review-pinout.png
