accel-kitchen/dna-accessory-console/design/functional-review/sources/bottom-pad-positioning/bottom-pad.png

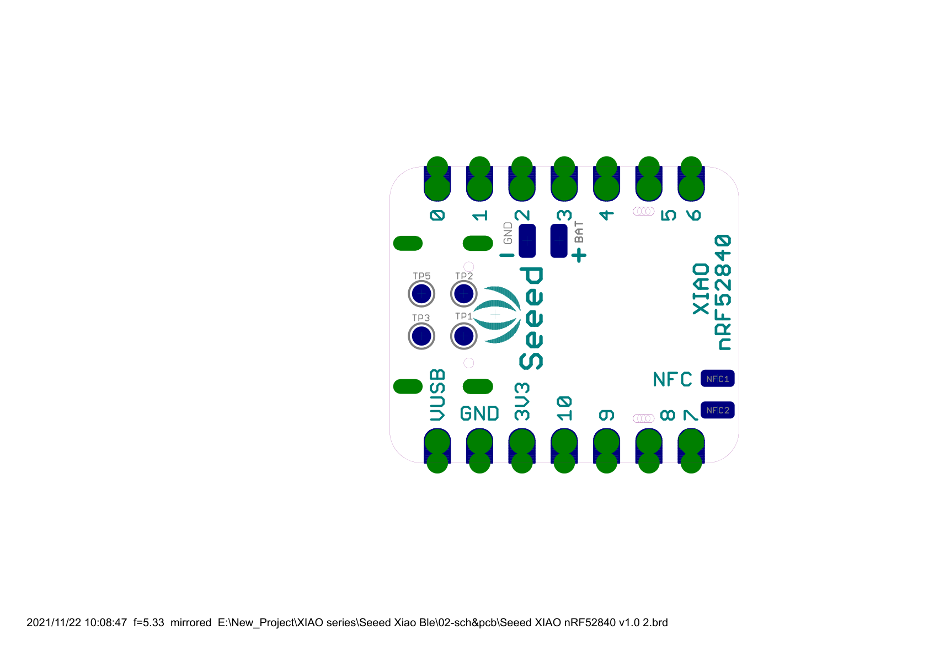
design/functional-review/sources/bottom-pad-positioning/bottom-pad.png
