accel-kitchen/dna-accessory-console/design/functional-review/sources/led-page-5.png

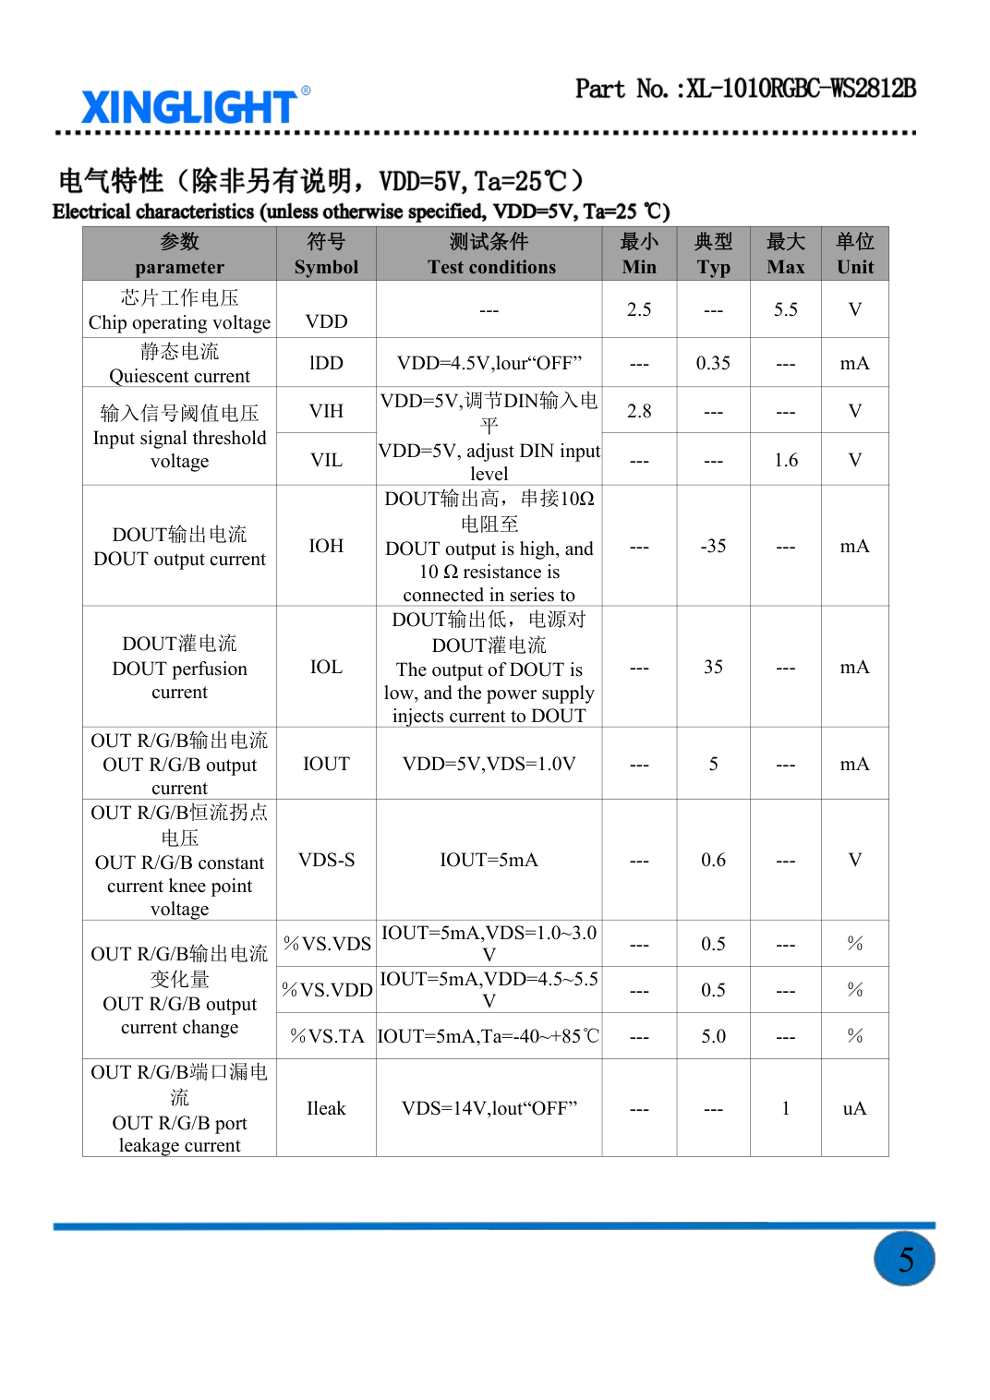
design/functional-review/sources/led-page-5.png
