accel-kitchen/dna-accessory-console/design/functional-review/sources/led-page-6.png

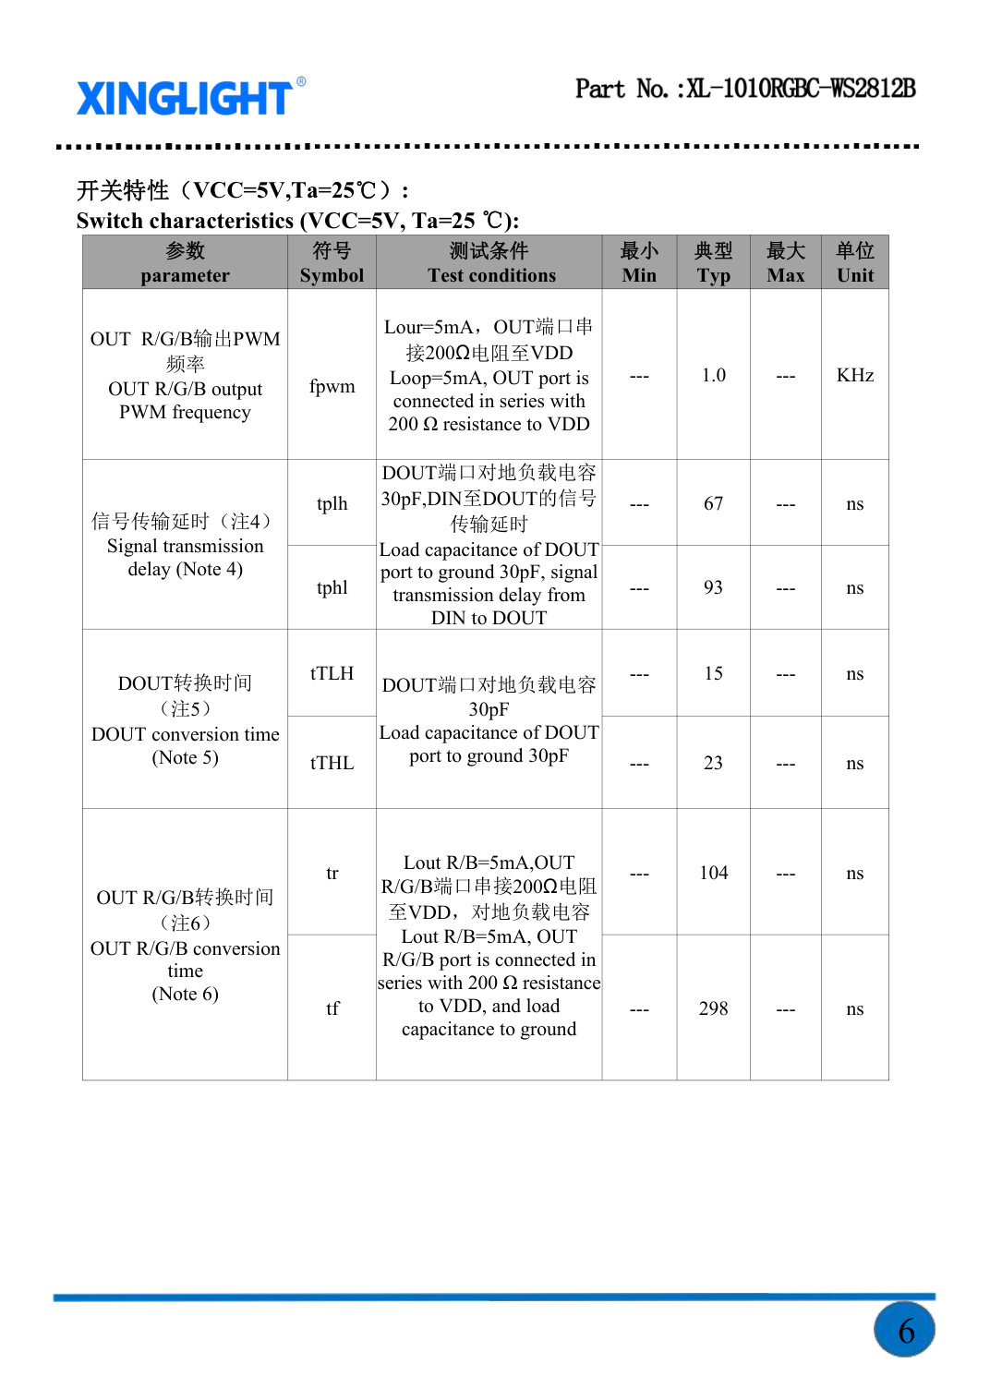
design/functional-review/sources/led-page-6.png
