accel-kitchen/dna-accessory-console/design/functional-review/sources/led-page-7.png

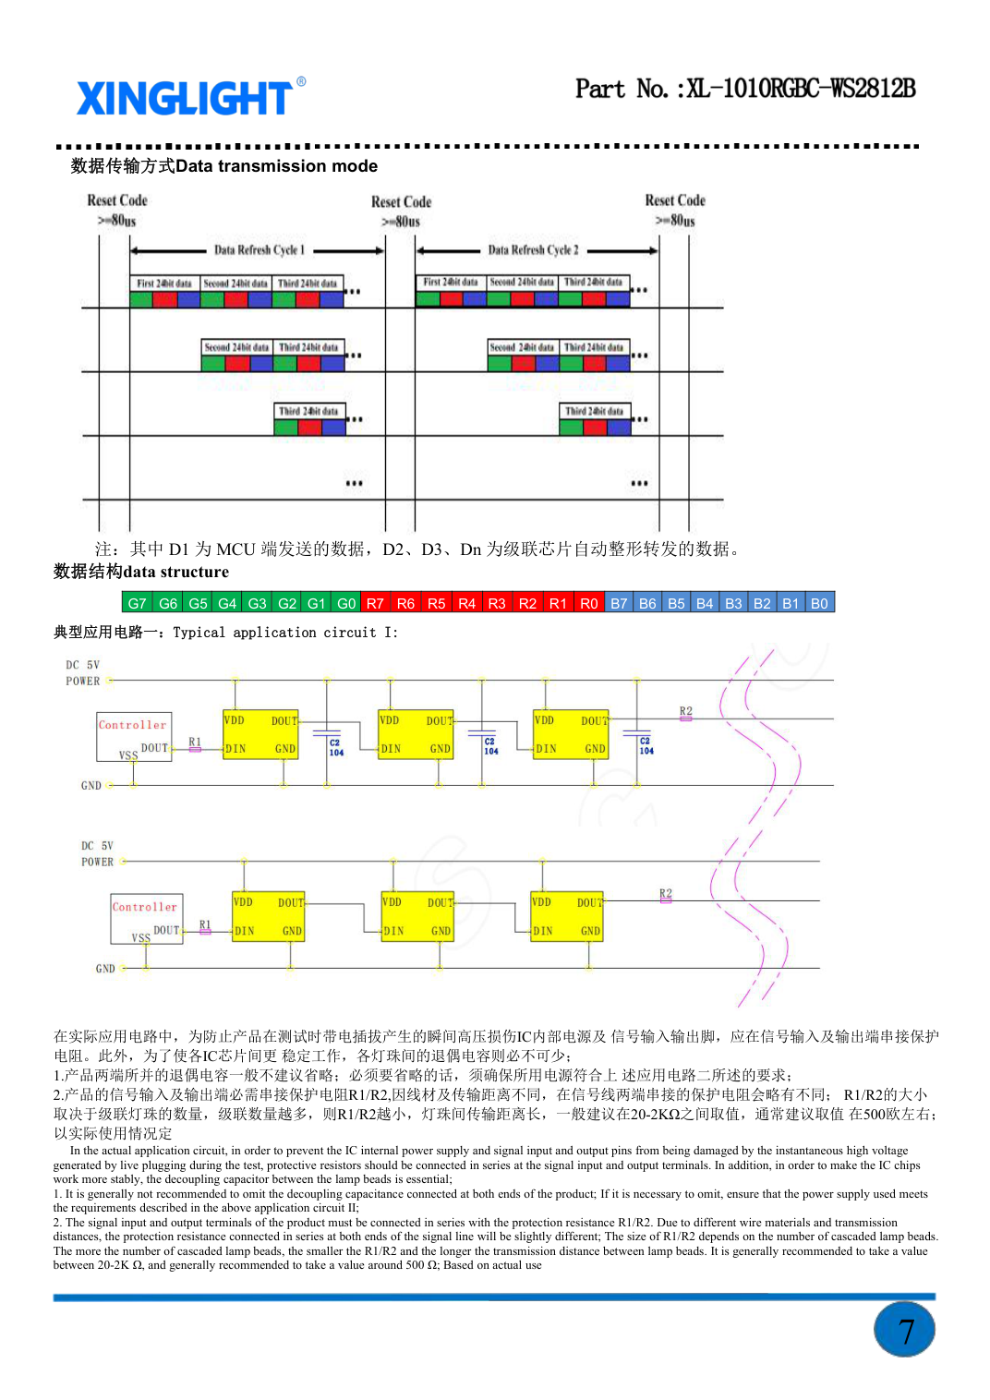
design/functional-review/sources/led-page-7.png
