accel-kitchen/dna-accessory-console/design/functional-review/sources/led-page-10.png

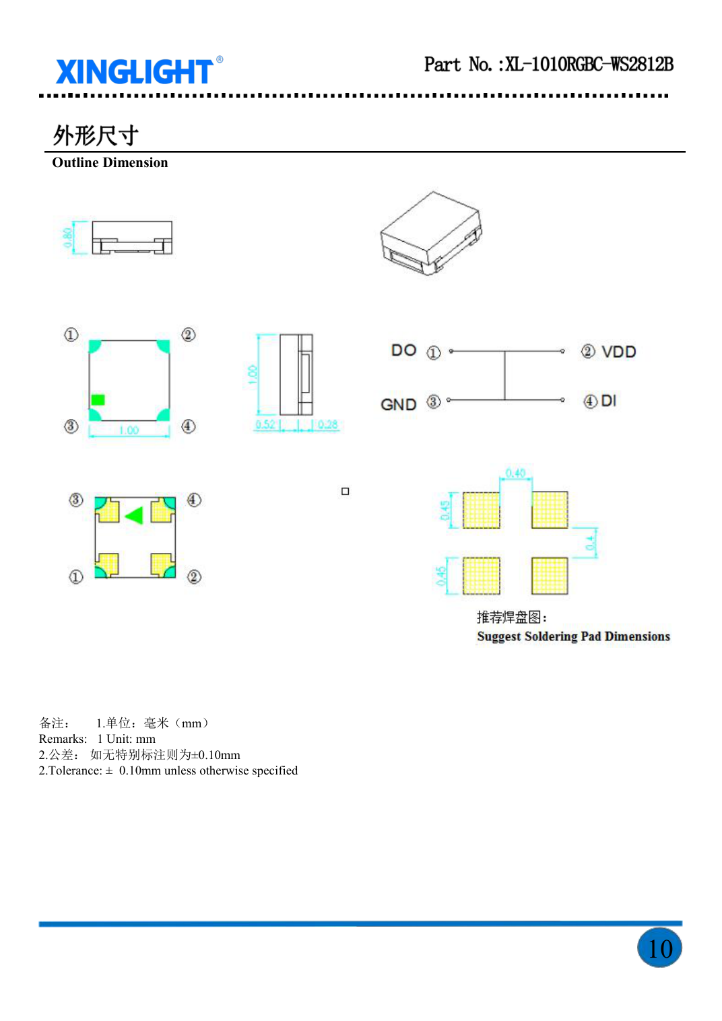
design/functional-review/sources/led-page-10.png
