accel-kitchen/dna-accessory-console/design/functional-review/sources/led-page-11.png

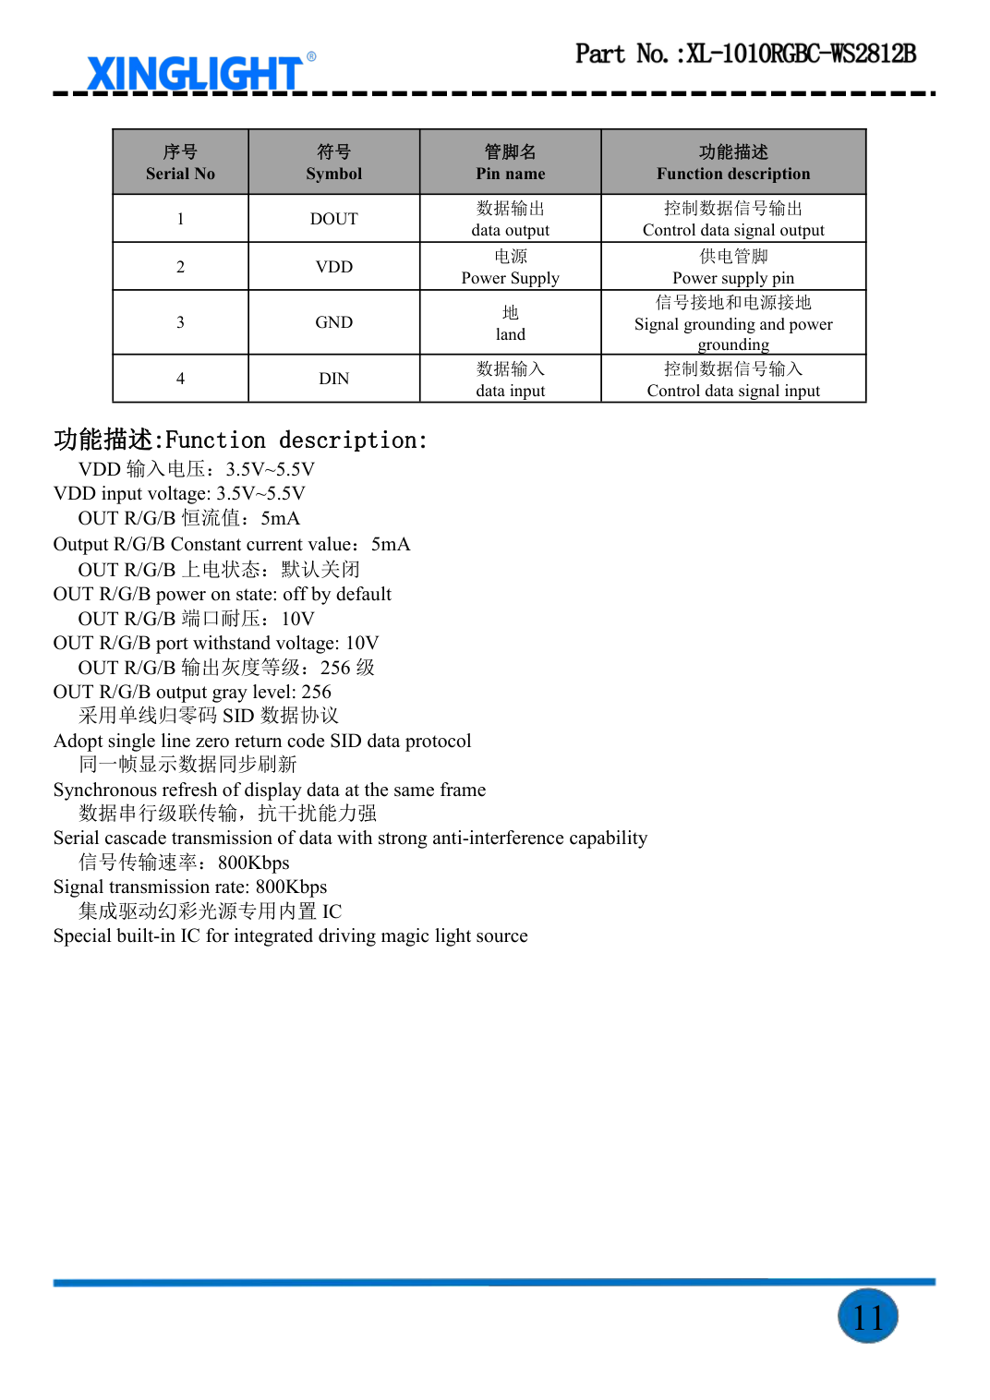
design/functional-review/sources/led-page-11.png
