accel-kitchen/dna-accessory-console/design/functional-review/sources/xiao-page-2.png

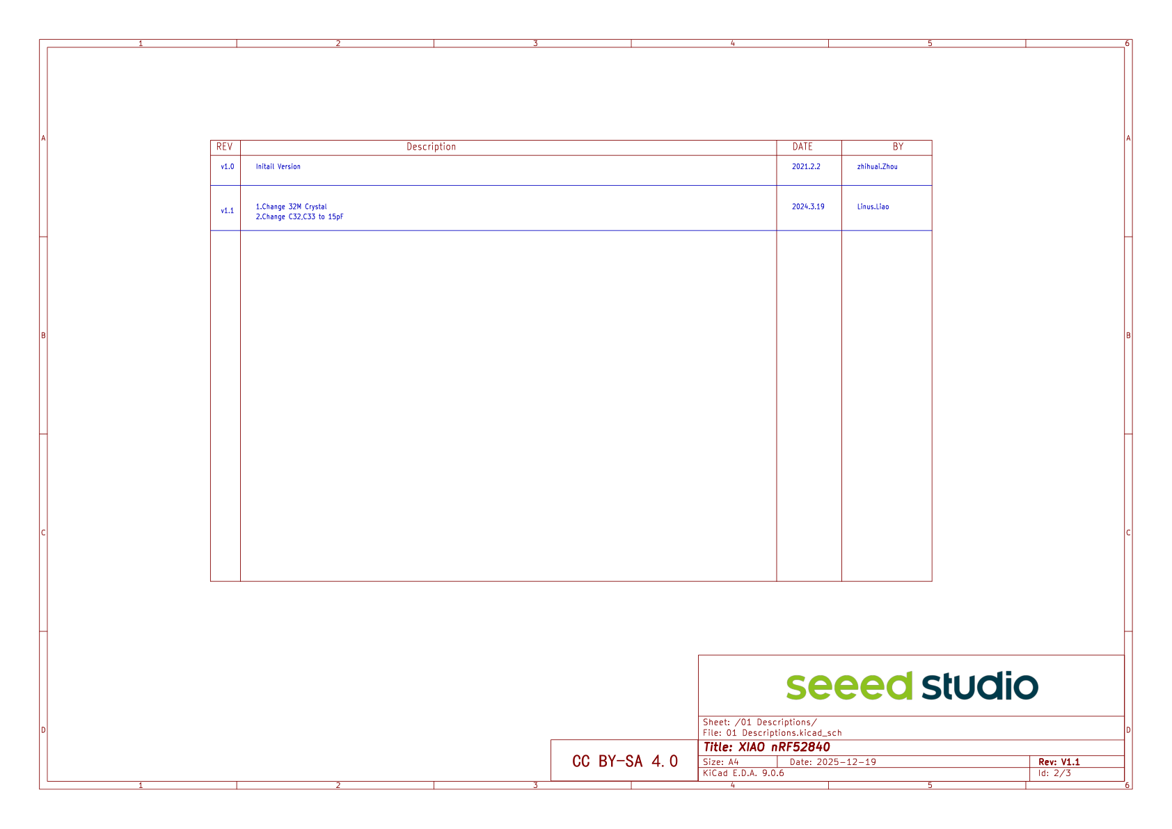
design/functional-review/sources/xiao-page-2.png
