accel-kitchen/dna-accessory-console/design/functional-review/sources/xiao-page-3.png

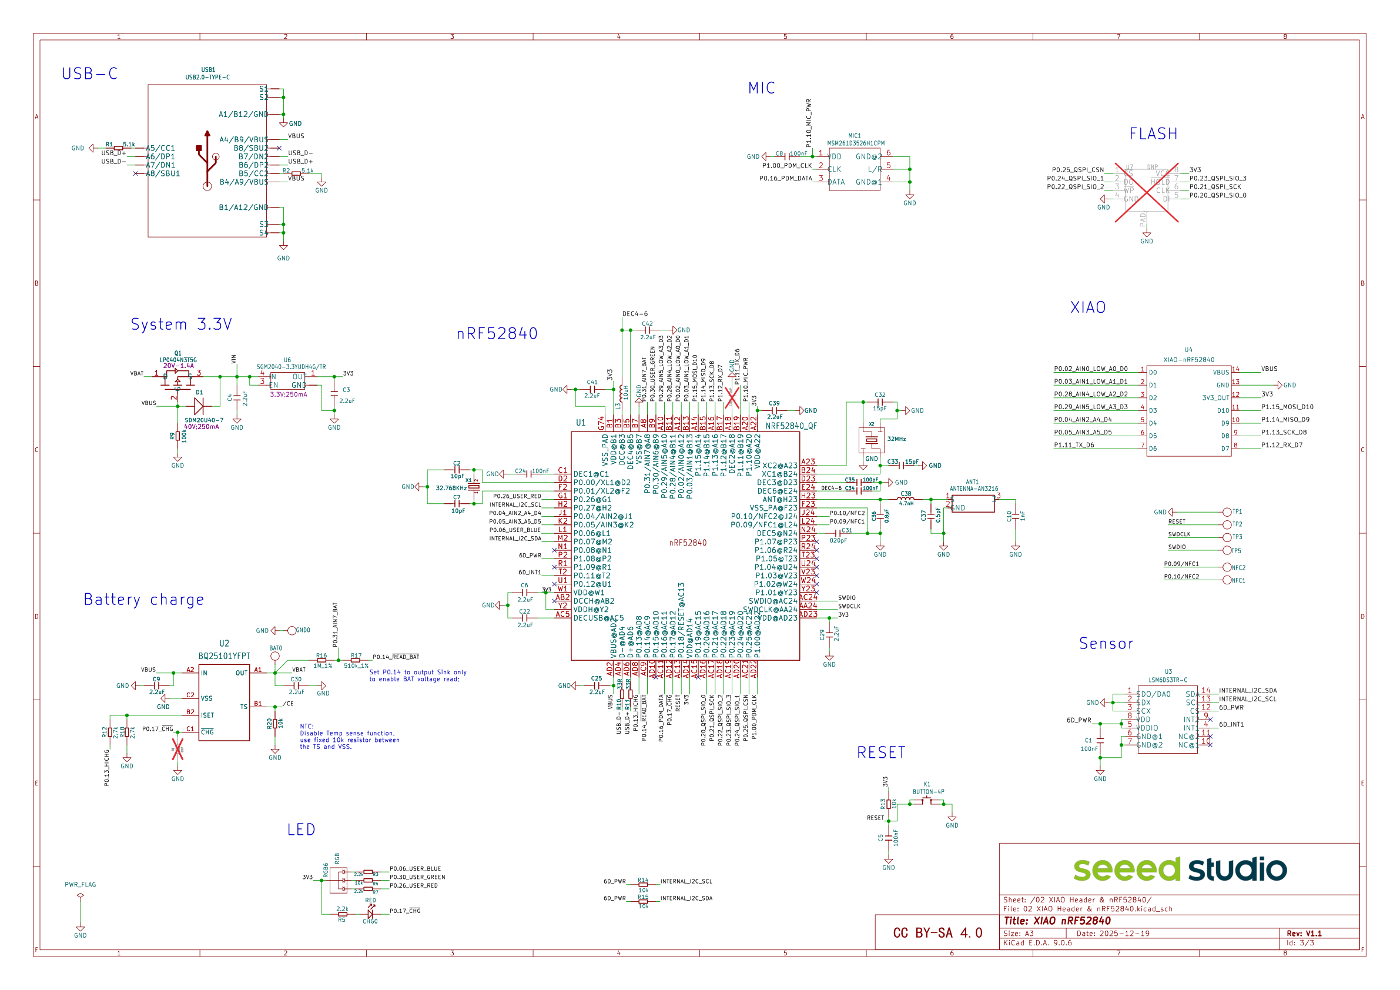
design/functional-review/sources/xiao-page-3.png
