accel-kitchen/dna-accessory-console/design/functional-review/sources/xiao-schematic.png

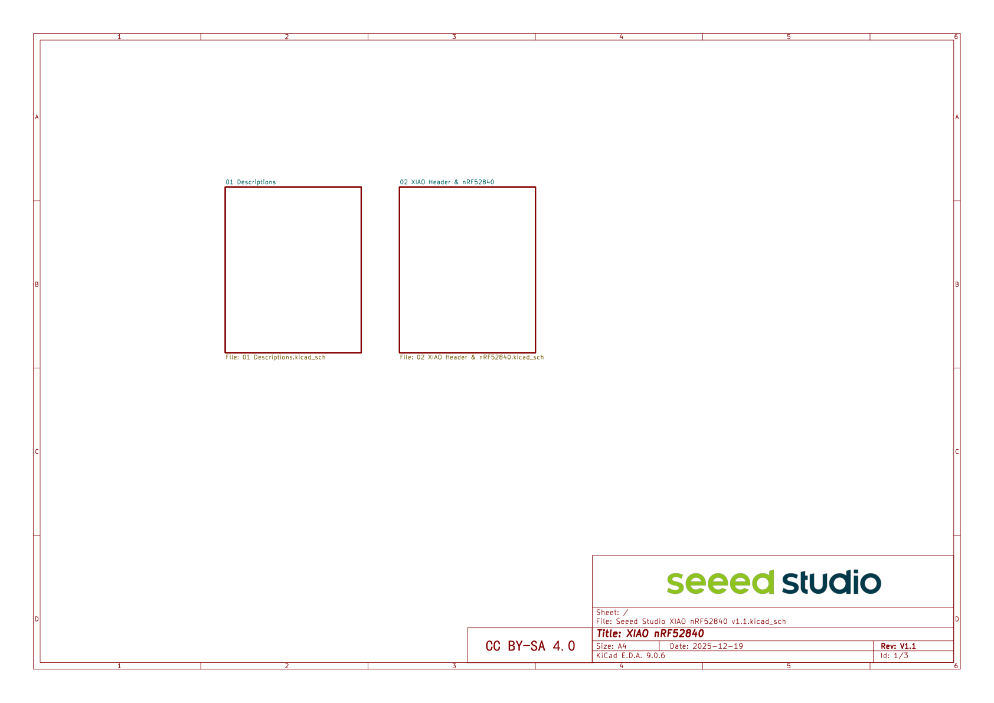
design/functional-review/sources/xiao-schematic.png
