accel-kitchen/dna-accessory-console/design/preview/3d-bottom.png

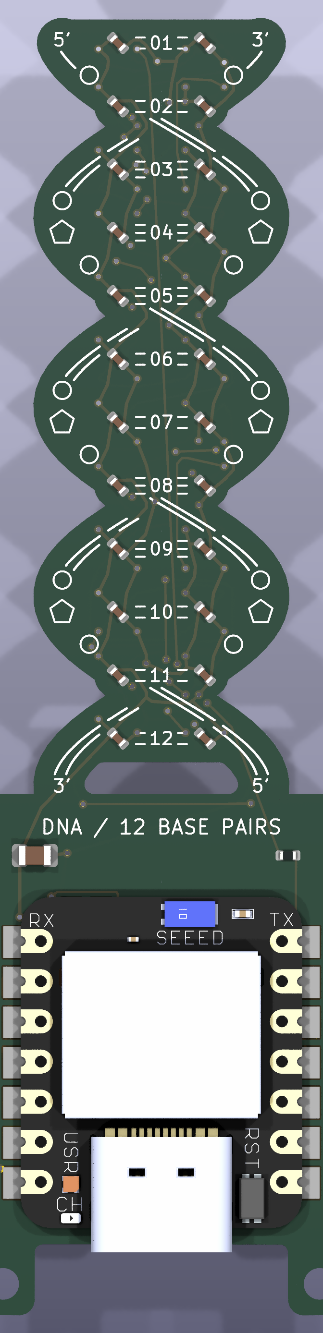
design/preview/3d-bottom.png
