accel-kitchen/dna-accessory-console/design/preview/3d-iso-collar.png

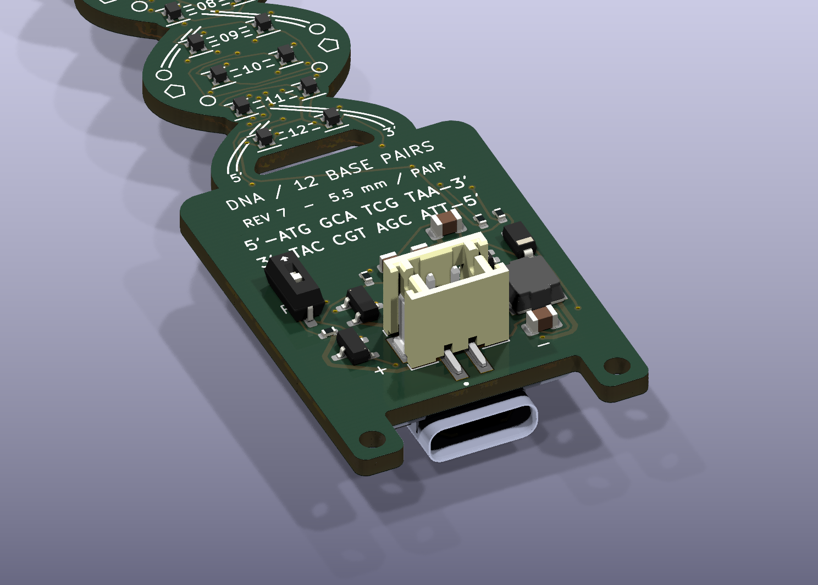
design/preview/3d-iso-collar.png
