accel-kitchen/dna-accessory-console/design/preview/3d-usb-side.png

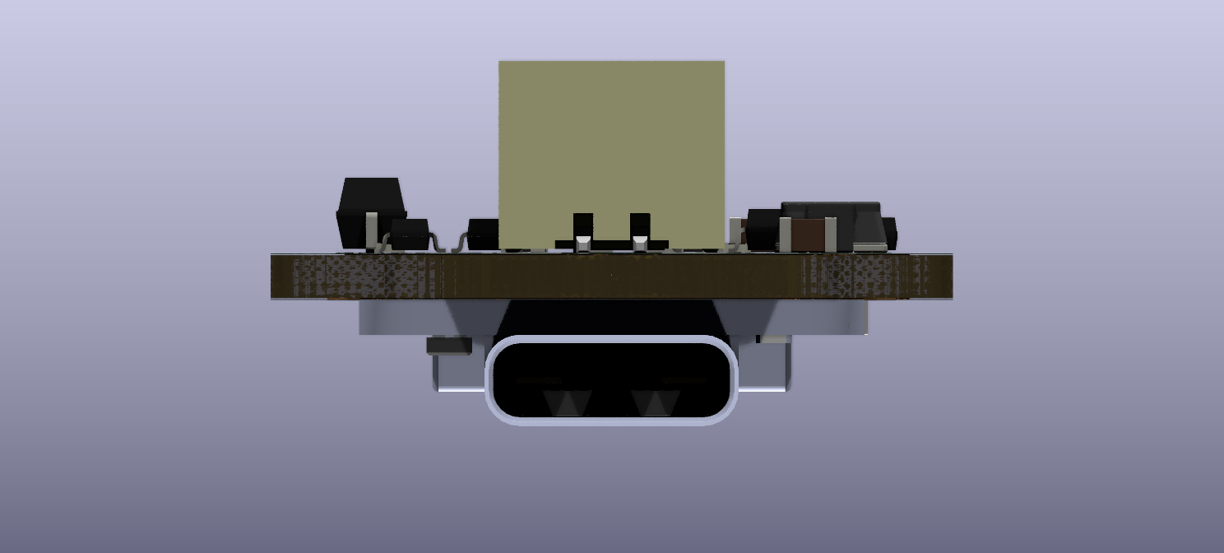
design/preview/3d-usb-side.png
