accel-kitchen/dna-accessory-console/design/preview/back-kicad.png

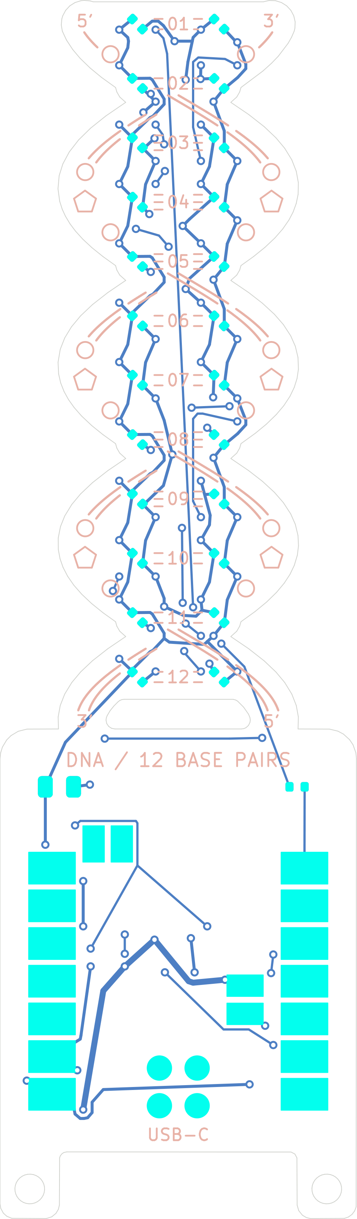
design/preview/back-kicad.png
