accel-kitchen/dna-accessory-console/design/preview/dna-layout.png

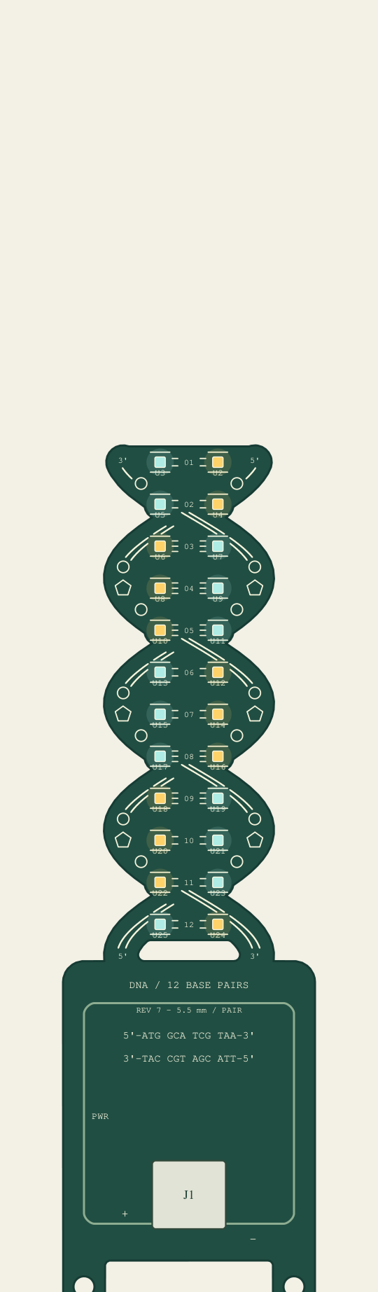
design/preview/dna-layout.png
