accel-kitchen/dna-accessory-console/design/preview/front-kicad.png

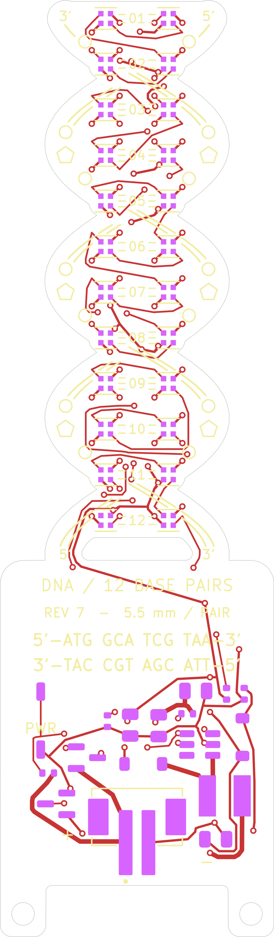
design/preview/front-kicad.png
