accel-kitchen/dna-accessory-console/lp/assets/img/board-tilt.png

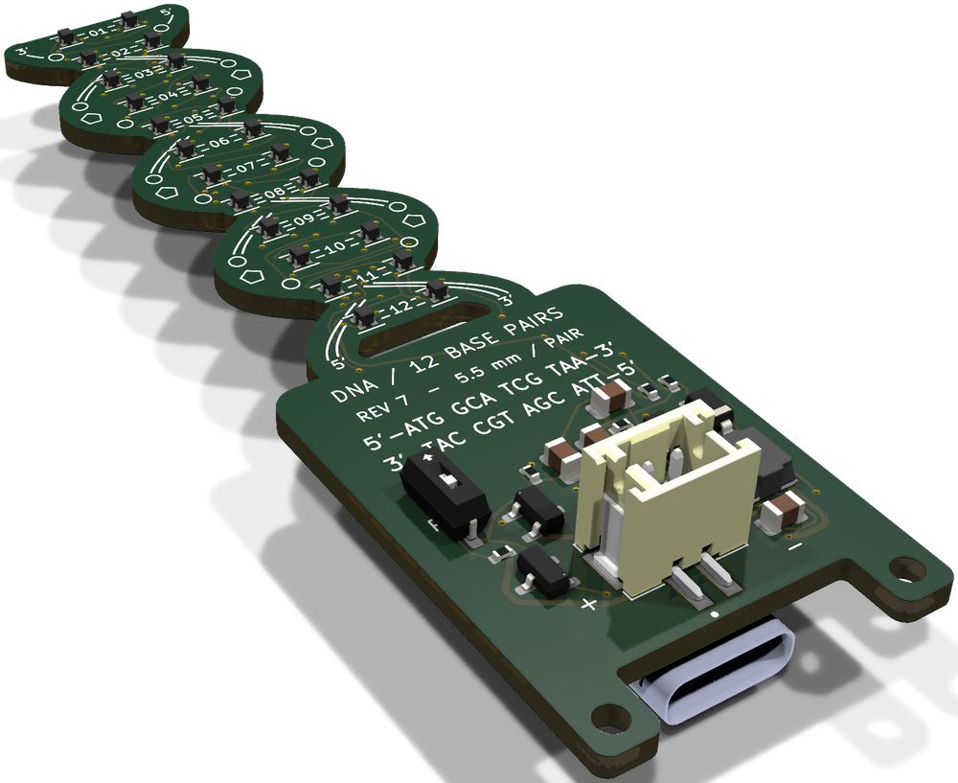
lp/assets/img/board-tilt.png
