accel-kitchen/dna-accessory-console/lp/assets/img/board-top.png

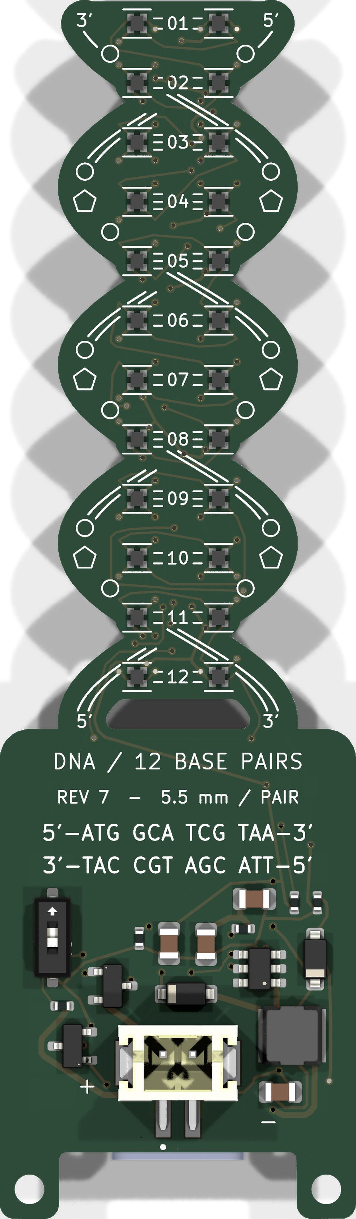
lp/assets/img/board-top.png
