accel-kitchen/dna-accessory-console/lp/assets/img/collar-back.png

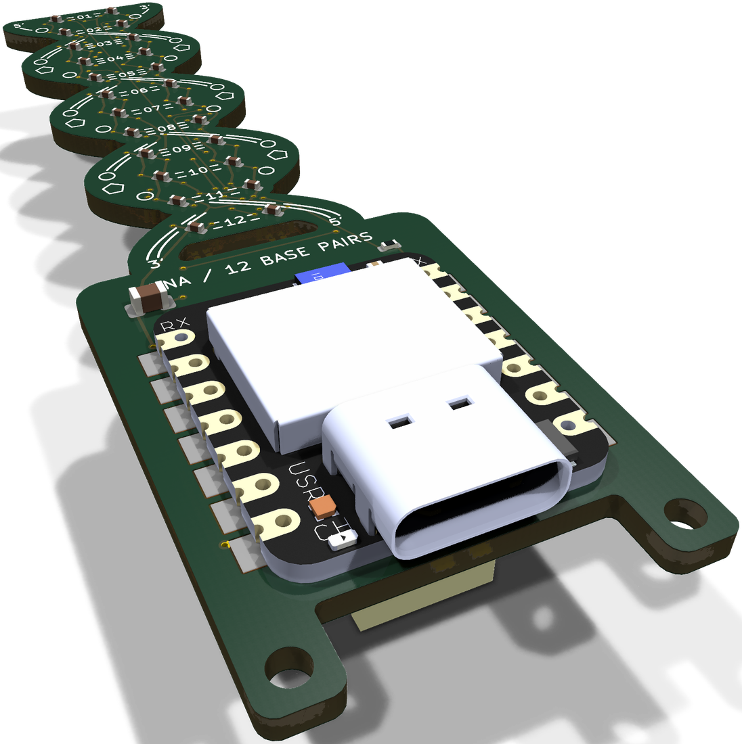
lp/assets/img/collar-back.png
