accel-kitchen/dna-accessory-console/lp/assets/img/collar-front.png

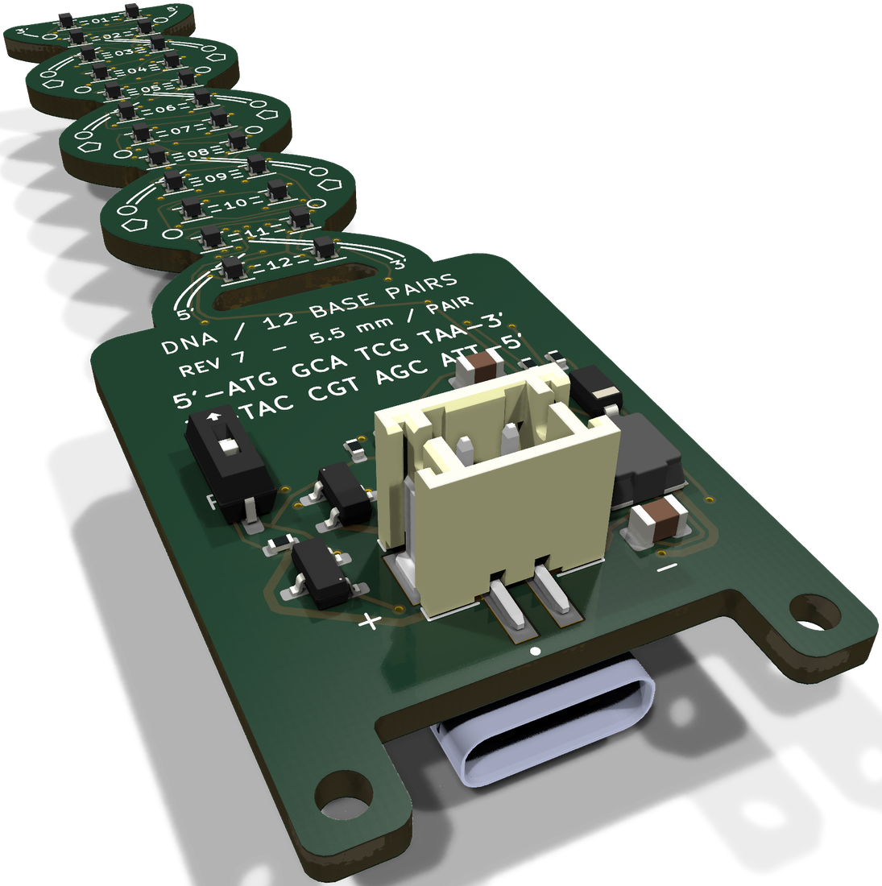
lp/assets/img/collar-front.png
