accel-kitchen/dna-accessory-console/lp/assets/img/scenes/scene-bag.jpg

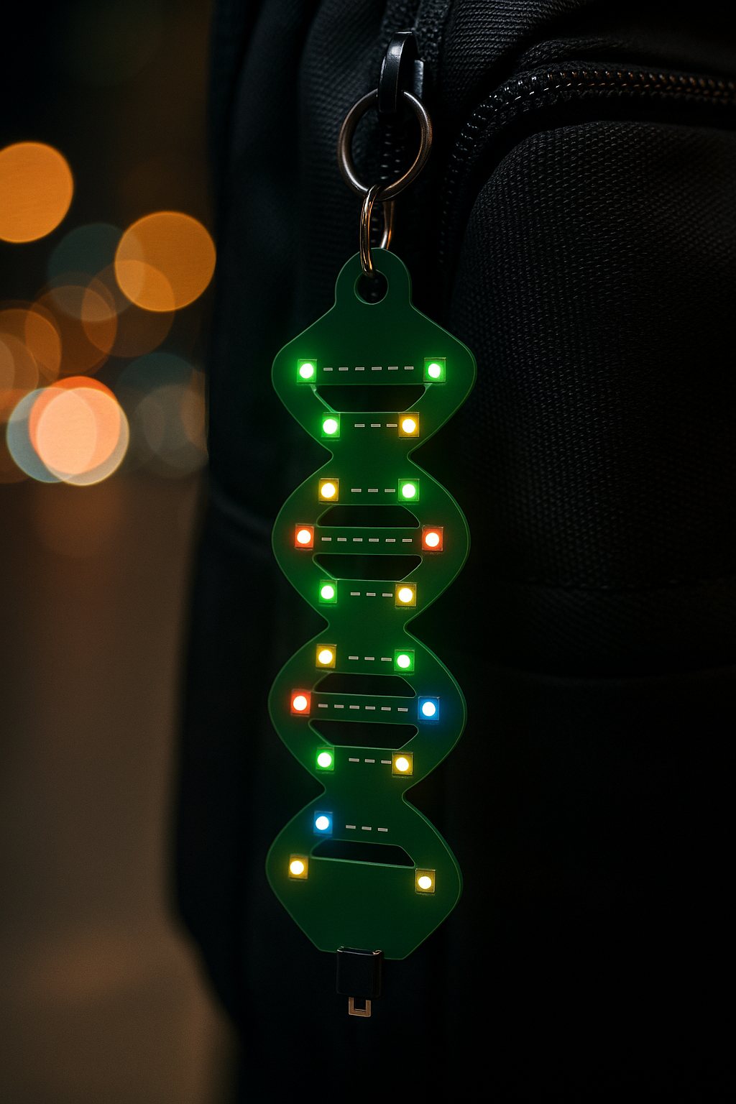
lp/assets/img/scenes/scene-bag.jpg
