accel-kitchen/dna-accessory-console/lp/assets/img/scenes/scene-necklace.jpg

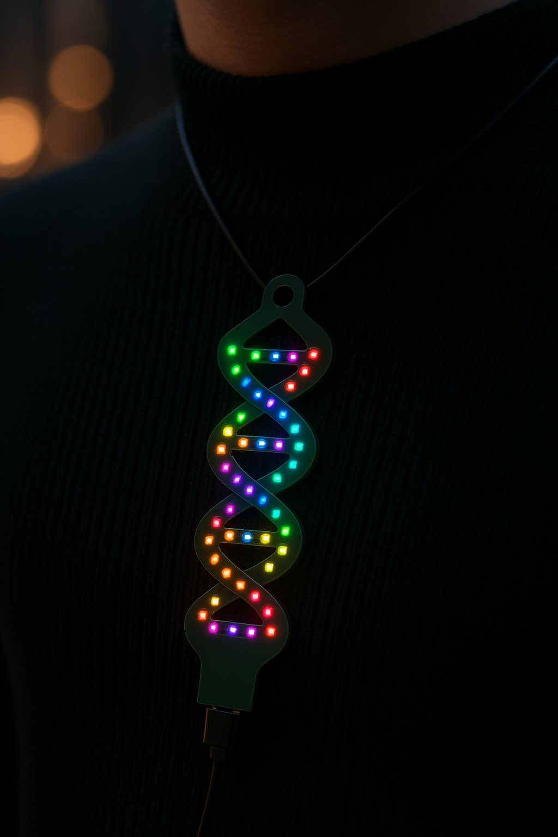
lp/assets/img/scenes/scene-necklace.jpg
