accel-kitchen/dna-accessory-console/lp/assets/img/scenes/scene-palm.jpg

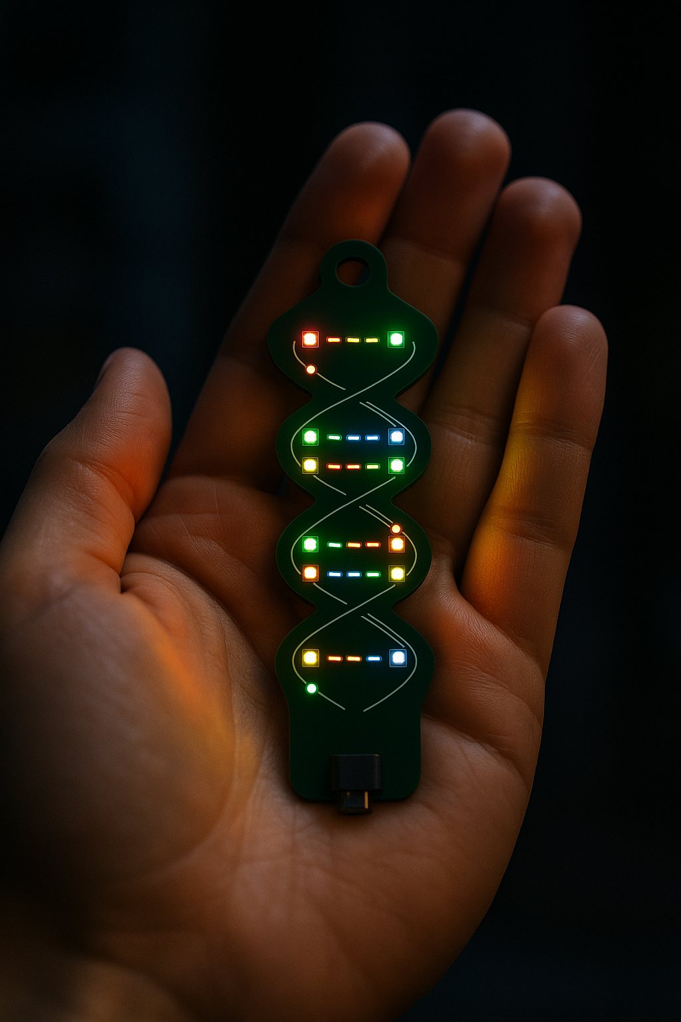
lp/assets/img/scenes/scene-palm.jpg
