accel-kitchen/dna-accessory-console/lp/assets/img/scenes/scene-walk.jpg

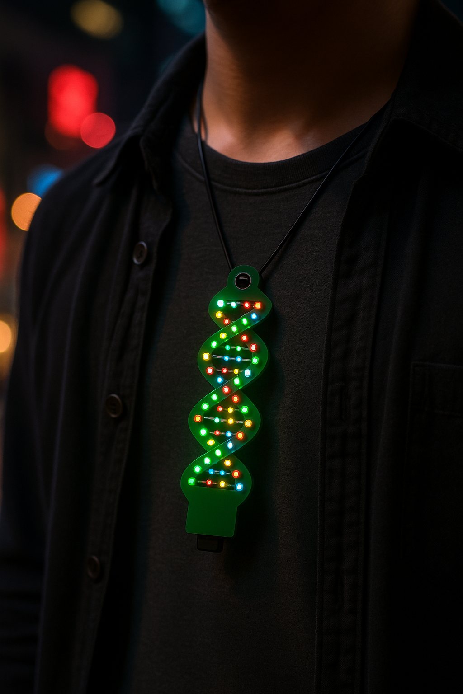
lp/assets/img/scenes/scene-walk.jpg
