accel-kitchen/dna-accessory-console/fusion/BOM_detail.xlsx

Designator | Qty | Value | Description | Package / footprint | Side | Manufacturer | MPN / Seeed SKU | LCSC # | Approved alternate | Assembly note | Link
U1 | 1 | 102010448 | Seeed Studio XIAO nRF52840 (XIAO BLE), plain version without pin headers | 21 x 17.8 mm castellated SMD module / MODULE_102010448 | bottom | Seeed Studio | 102010448 |  |  | Seeed SKU 102010448 (NOT the "Pre-Soldered" variant 102010631). Bottom side of the PCB; USB-C end faces the board bottom edge. | https://www.seeedstudio.com/Seeed-XIAO-BLE-nRF52840-p-5201.html
J1 | 1 | B2B-PH-SM4-TB | PH-series 2-pin 2.0 mm pitch SMD side-entry wafer, tin plated | SMD, side entry / JST_B2B-PH-SM4-TB | top | JST | B2B-PH-SM4-TB(LF)(SN) | C160352 |  | Battery connector. Pad 1 = BAT+ (left, "+" on the silkscreen), pad 2 = BAT-. Datasheet: jst-mfg.com ePH.pdf | https://www.lcsc.com/product-detail/image/B2B-PH-SM4-TB-LF-SN_C160352.html
U2,U3,U4,U5,U6,U7,U8,U9,U10,U11,U12,U13,U14,U15,U16,U17,U18,U19,U20,U21,U22,U23,U24,U25 | 24 | XL-1010RGBC-WS2812B | 1010 RGB LED with built-in WS2812B-type driver, 4-pad | 1.0 x 1.0 mm SMD (4 pad) / SMD4_XL-1010RGBC_XLG | top | XINGLIGHT | XL-1010RGBC-WS2812B | C5349953 |  | Orientation-sensitive (pad 1 = DOUT). MSL: confirm with the reel label and bake if needed before reflow. | https://www.lcsc.com/product-detail/Light-Emitting-Diodes-LED_XINGLIGHT-XL-1010RGBC-WS2812B_C5349953.html
U26 | 1 | MT3608B | 1.2 MHz step-up converter, 2.5-24 V in, 4 A switch, adjustable output, SOT-23-6 | SOT-23-6 / SOT-23-6 | top | Aerosemi | MT3608B |  | MT3608 (same SOT-23-6 pinout: 1 SW, 2 GND, 3 FB, 4 EN, 5 VIN, 6 NC) | Pin 1 = SW (see detail E). Output 5.0 V = 0.6 V x (1 + 110k/15k). Battery to LED boost; switched off by Q1 while USB is present. | https://www.lcsc.com/search?q=MT3608B
L1 | 1 | 10uH | Shielded power inductor 10 uH, Irms 1.2 A, Isat 1.3 A, DCR 0.15 ohm max, 4.0 x 4.0 x 1.8 mm | 4.0 x 4.0 mm SMD / L_Bourns-SRN4018 | top | Bourns | SRN4018TA-100M |  | Sunlord SWPA4020S100MT (LCSC C82398; 10 uH, Irms 0.9 A, Isat 1.6 A, 4 x 4 x 2 mm): check its land pattern before substituting | Non-polarized. Boost inductor: carries up to ~0.8 A at full white on a 3.0 V cell. | https://www.digikey.com/en/products/result?keywords=SRN4018TA-100M
D1,D2 | 2 | 1N5819HW | Schottky diode 40 V 1 A, SOD-123 | SOD-123 / D_SOD-123 | top | Diodes Incorporated | 1N5819HW-7-F | C82544 | Any SOD-123 Schottky, 40 V, 1 A, Vf <= 0.5 V at 1 A | Polarized: cathode (bar) at pad 1. D1 = boost rectifier, D2 = USB to LED power (blocks battery current into USB). | https://lcsc.com/product-detail/Schottky-Diodes_Diodes-Incorporated-1N5819HW-7-F_C82544.html
Q1 | 1 | 2N7002 | N-channel MOSFET 60 V 210 mA, SOT-23 | SOT-23 / SOT-23 | top | Diodes Incorporated | 2N7002-7-F | C85049 | 2N7002K-7 (LCSC C85047) | Pin 1 = gate, 2 = source, 3 = drain. Pulls the boost EN pin low while USB is present. | https://www.lcsc.com/product-detail/C85049.html
C25,C26,C27,C28,C29 | 5 | 10uF | MLCC 10 uF 25 V X5R +/-10 % 0805 | 0805 (2012 metric) / C_0805_2012Metric | bottom/top | Samsung Electro-Mechanics | CL21A106KAYNNNE | C15850 | Murata GRM21BR61E106KA73L (same value/voltage/dielectric) | Non-polarized. Bulk capacitor on the 5 V rail. | https://www.lcsc.com/product-detail/C15850.html
C1,C2,C3,C4,C5,C6,C7,C8,C9,C10,C11,C12,C13,C14,C15,C16,C17,C18,C19,C20,C21,C22,C23,C24 | 24 | 100nF | MLCC 100 nF 25 V X7R +/-10 % 0402 | 0402 (1005 metric) / C_0402_1005Metric | bottom | Samsung Electro-Mechanics | CL05B104KA5NNNC |  | Murata GRM155R71E104KE14D (same value/voltage/dielectric) | Non-polarized. One per LED, back side, directly behind the LED. | https://www.digikey.com/en/products/detail/samsung-electro-mechanics/CL05B104KA5NNNC/5961204
R1 | 1 | 100 | Thick-film resistor 100 ohm 1 % 1/16 W 0402 | 0402 (1005 metric) / R_0402_1005Metric | bottom | Yageo | RC0402FR-07100RL | C106232 | UNI-ROYAL 0402WGF1000TCE | Series resistor in the LED data line (XIAO D6 -> U2 DIN). | https://www.lcsc.com/product-detail/C106232.html
R2 | 1 | 110k | Thick-film resistor 110 kohm 1 % 1/16 W 0402 | 0402 (1005 metric) / R_0402_1005Metric | top | Yageo | RC0402FR-07110KL |  | Any 0402 110 kohm 1 % | Boost feedback divider (top): 5.0 V output with R3 = 15 kohm. | https://www.lcsc.com/search?q=RC0402FR-07110KL
R3 | 1 | 15k | Thick-film resistor 15 kohm 1 % 1/16 W 0402 | 0402 (1005 metric) / R_0402_1005Metric | top | Yageo | RC0402FR-0715KL |  | Any 0402 15 kohm 1 % | Boost feedback divider (bottom). | https://www.lcsc.com/search?q=RC0402FR-0715KL
R4,R5,R6 | 3 | 100k | Thick-film resistor 100 kohm 1 % 1/16 W 0402 | 0402 (1005 metric) / R_0402_1005Metric | top | Yageo | RC0402FR-07100KL |  | Any 0402 100 kohm | R4: boost EN pull-up to the battery. R5: gate pull-down of Q1. R6: gate pull-up of the power switch Q2 (holds it off). | https://www.lcsc.com/search?q=RC0402FR-07100KL
Q2 | 1 | AO3401A | P-channel MOSFET -30 V -4 A, Rds(on) 60 mohm at Vgs -4.5 V, SOT-23 | SOT-23 / SOT-23 | top | Alpha & Omega Semiconductor | AO3401A |  | Any SOT-23 P-MOSFET with pinout 1 gate / 2 source / 3 drain, Vgs(th) <= -1.3 V, Rds(on) <= 100 mohm at -2.5 V (e.g. SI2301, AO3407A) | Q2 = battery power switch. Pin 1 = gate, 2 = source (battery side, J1 pad 1), 3 = drain (VBAT after the switch). Check the pinout of the substitute. | https://www.lcsc.com/search?q=AO3401A
SW1 | 1 | SLIDE_SW | 1-position SPST SMD slide (DIP-type) switch, J-hook terminals, 5.08 mm span, 100 mA 6 VDC | SMD, J-hook, 7.3 x 3.3 mm / SW_DIP_SPSTx01_Slide_Copal_CHS-01A_W5.08mm_P1.27mm_JPin | top | Nidec Copal | CHS-01A | C132834 | Any 1-position SMD slide switch with J-hook leads and 5.08 mm lead span (KiCad footprint SW_DIP_SPSTx01_Slide_Copal_CHS-01A_W5.08mm_P1.27mm_JPin) | SW1 = power switch: it only switches the gate of Q2 (microamps), not the battery current. ON = the end marked ON on the body. No polarity. | https://lcsc.com/product-detail/DIP-Switches_Nidec-CHS-01A_C132834.html
