accel-kitchen/dna-accessory-console/fusion/BOM-wo-xiaoxlsx.xlsx

Designator | Manufacturer Part Number or Seeed SKU | Qty | Link
J1 | B2B-PH-SM4-TB(LF)(SN) | 1 | https://www.lcsc.com/product-detail/image/B2B-PH-SM4-TB-LF-SN_C160352.html (https://statics3.seeedstudio.com/images/opl/datasheet/318020010.pdf)
U2,U3,U4,U5,U6,U7,U8,U9,U10,U11,U12,U13,U14,U15,U16,U17,U18,U19,U20,U21,U22,U23,U24,U25 | XL-1010RGBC-WS2812B | 24 | https://www.lcsc.com/product-detail/Light-Emitting-Diodes-LED_XINGLIGHT-XL-1010RGBC-WS2812B_C5349953.html (https://www.digikey.com.cn/product-detail/zh/cypress-semiconductor-corp/CYBLE-014008-00/428-3600-1-ND/6052585)
C25 | CL21A106KAYNNNE | 1 | https://www.lcsc.com/product-detail/C15850.html
C1,C2,C3,C4,C5,C6,C7,C8,C9,C10,C11,C12,C13,C14,C15,C16,C17,C18,C19,C20,C21,C22,C23,C24 | CL05B104KA5NNNC | 24 | https://www.digikey.com/en/products/detail/samsung-electro-mechanics/CL05B104KA5NNNC/5961204
R1 | RC0402FR-07100RL | 1 | https://www.lcsc.com/product-detail/C106232.html
