accel-kitchen/dna-accessory-console/design/functional-review/review-operation.png

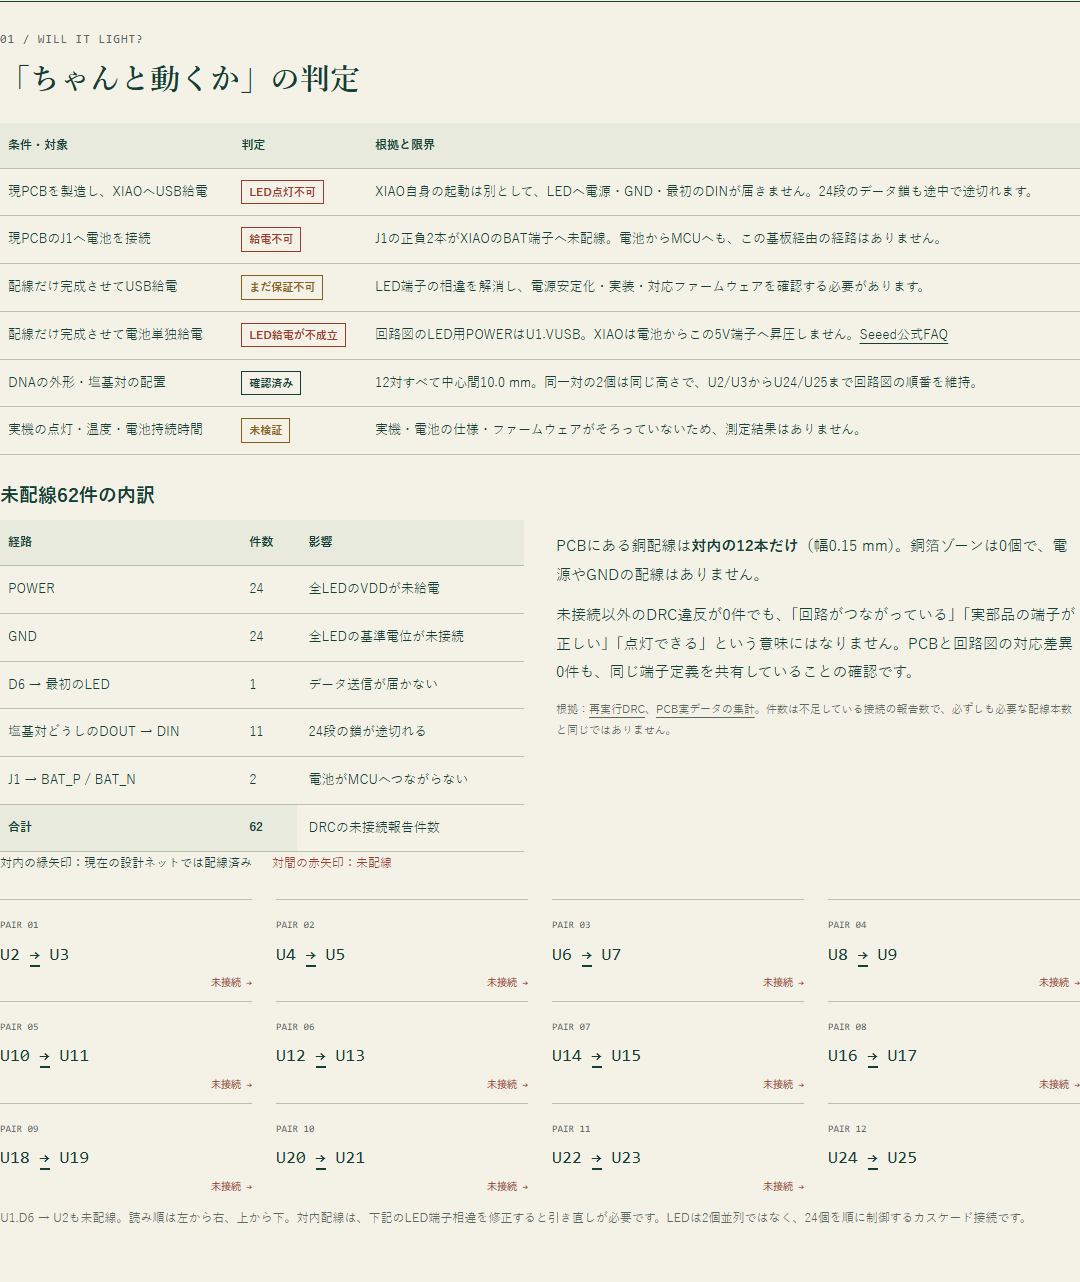
design/functional-review/review-operation.png
