accel-kitchen/dna-accessory-console/vector/cat-line.pdf

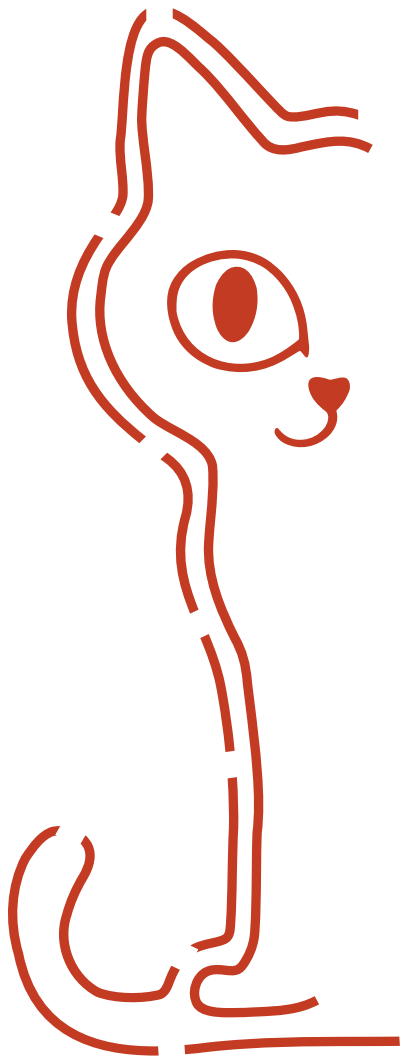
[picture p34: page 1]

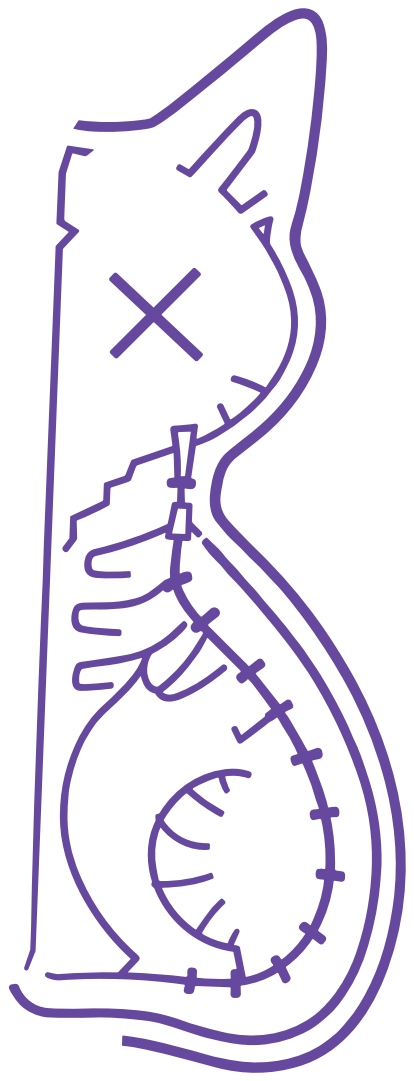
[picture p35: page 2]
