accel-kitchen/dna-accessory-console/dna-accesories.kicad_pcb

## KiCad design dna-accesories.kicad_pcb (2026-11-06)

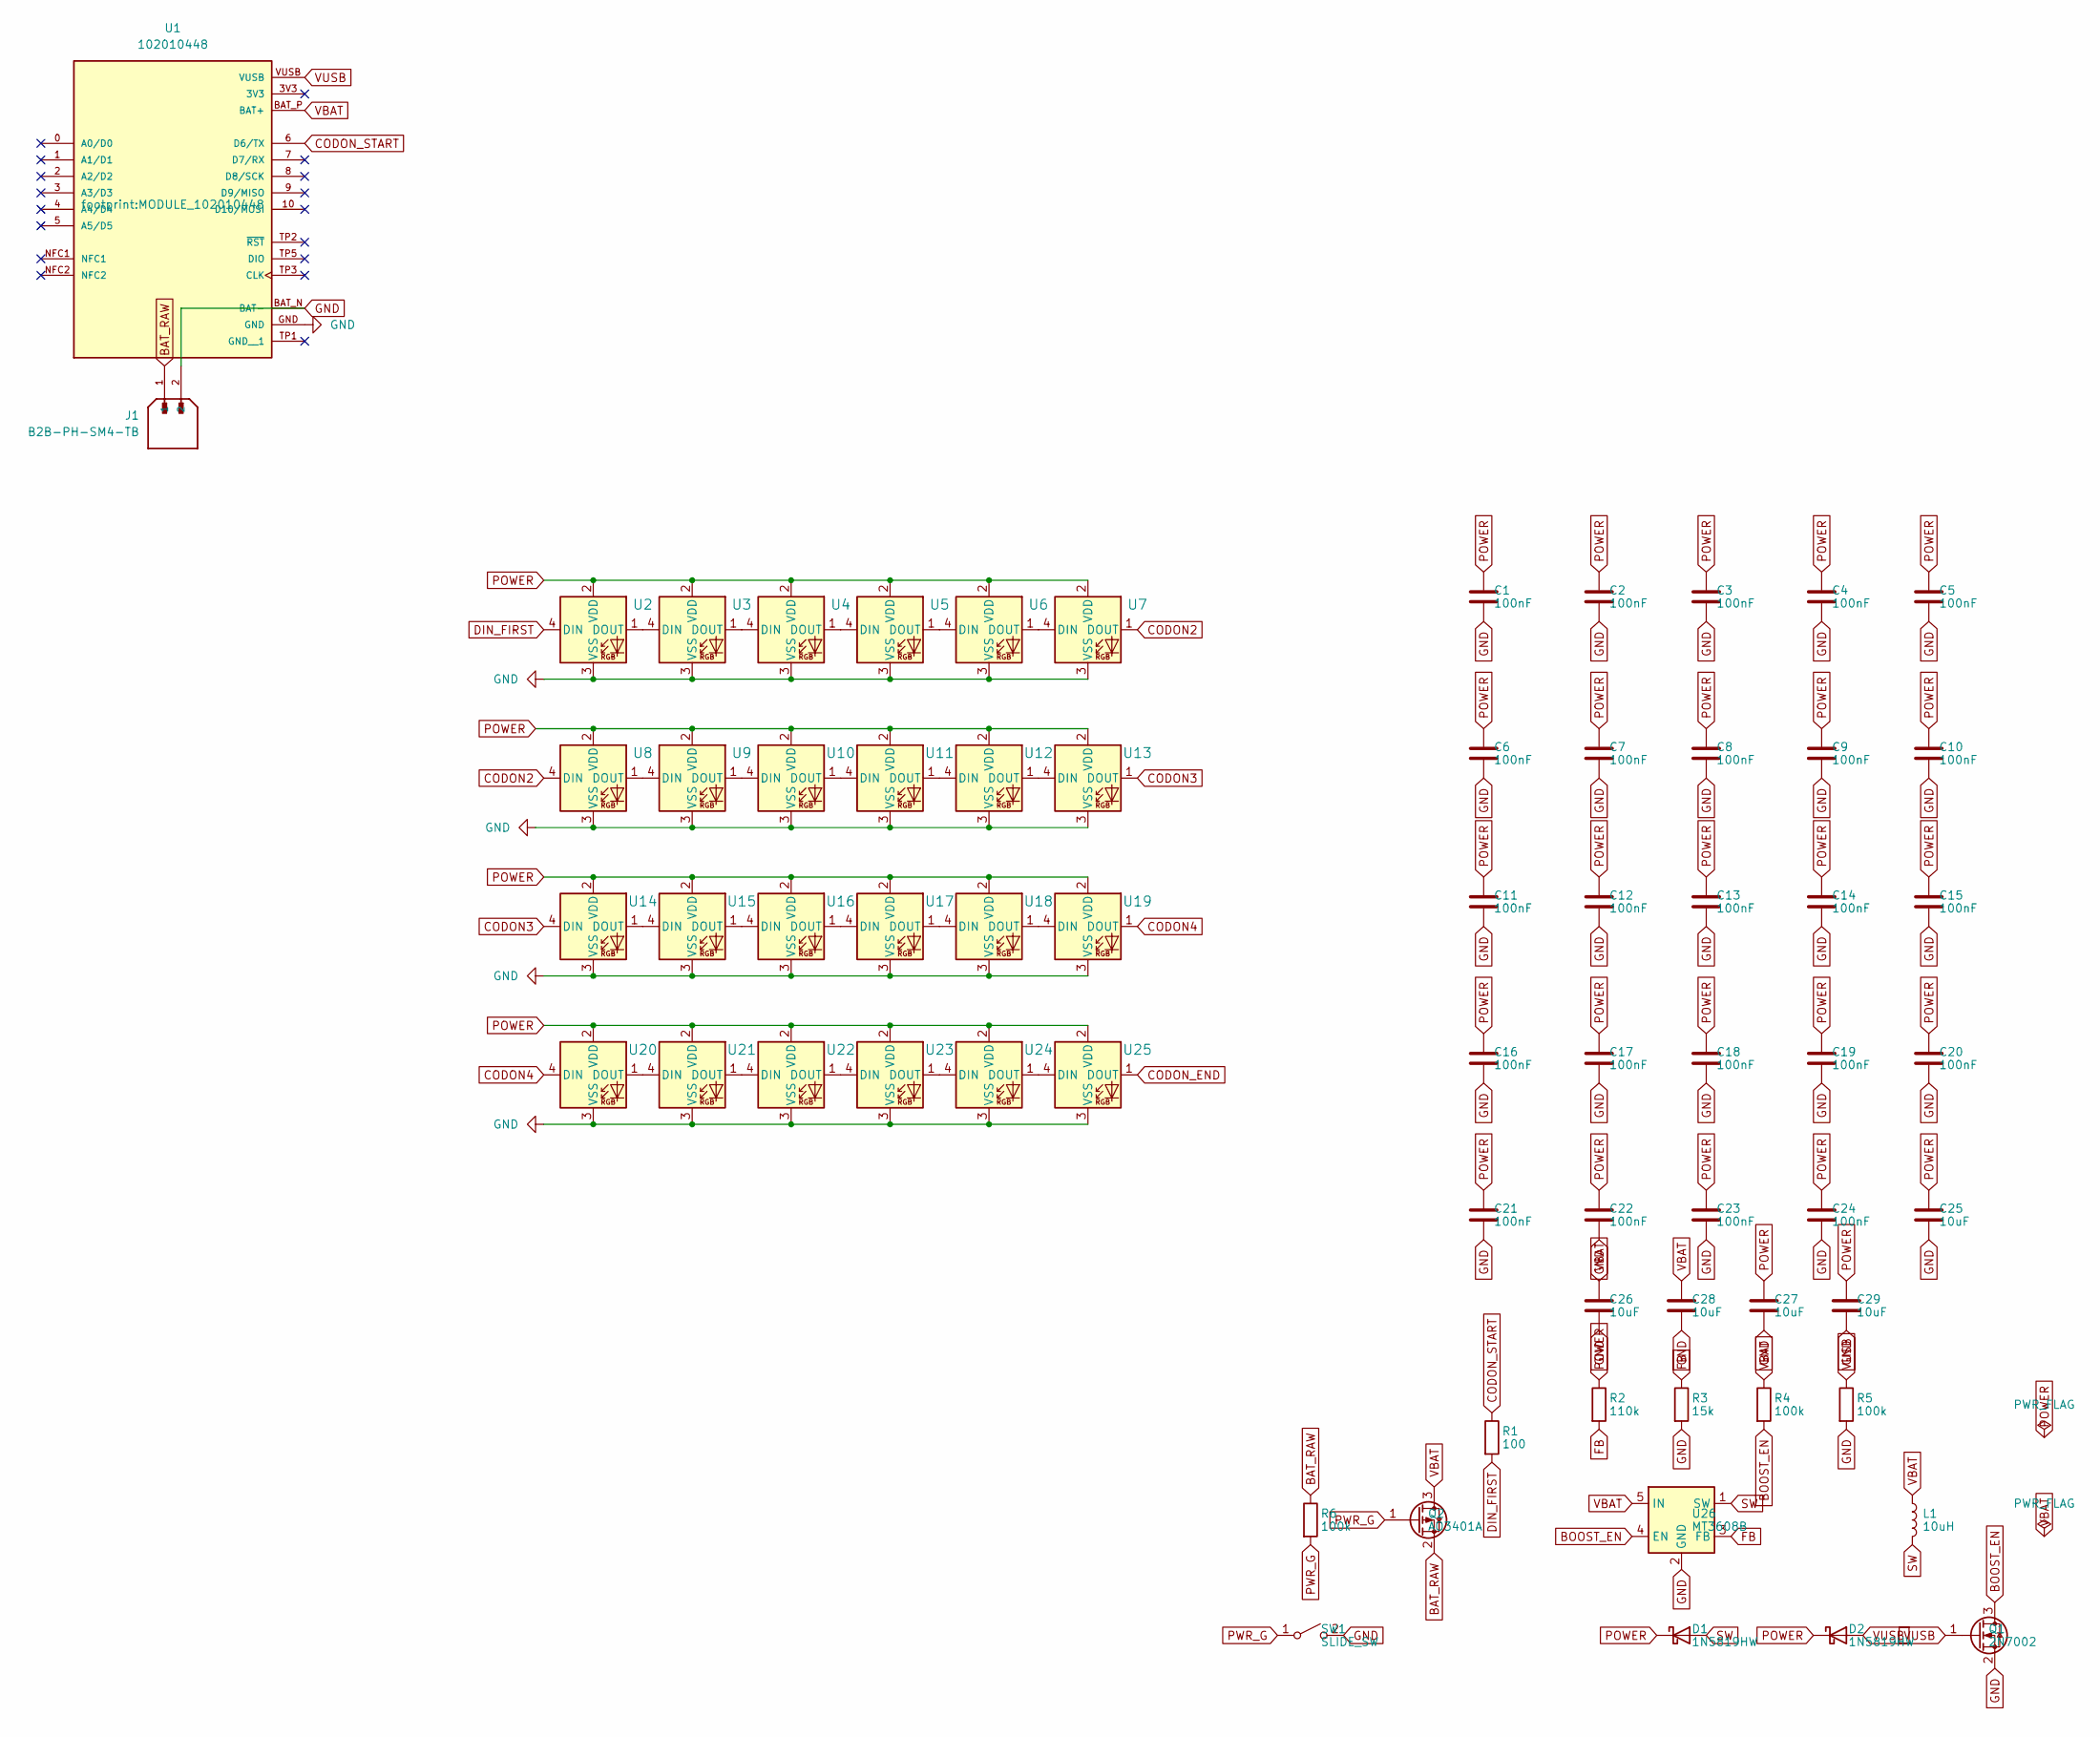
[picture p36: schematic dna-accesories.kicad_sch]

Parts:
C1, C2, C3, C4, C5, C6, C7, C8, C9, C10, C11, C12, C13, C14, C15, C16, C17, C18, C19, C20, C21, C22, C23, C24: 100nF; C_0402_1005Metric
C25, C26, C27, C28, C29: 10uF; C_0805_2012Metric
D1, D2: 1N5819HW; D_SOD-123
J1: B2B-PH-SM4-TB; JST_B2B-PH-SM4-TB; PARTREV N/A
L1: 10uH; L_Bourns-SRN4018
Q1: 2N7002; SOT-23
Q2: AO3401A; SOT-23
R1: 100; R_0402_1005Metric
R2: 110k; R_0402_1005Metric
R3: 15k; R_0402_1005Metric
R4, R5, R6: 100k; R_0402_1005Metric
SW1: SLIDE_SW; SW_DIP_SPSTx01_Slide_Copal_CHS-01A_W5.08mm_P1.27mm_JPin
U1: 102010448; MODULE_102010448; PARTREV 2022/08/18
U2, U3, U4, U5, U6, U7, U8, U9, U10, U11, U12, U13, U14, U15, U16, U17, U18, U19, U20, U21, U22, U23, U24, U25: XL-1010RGBC-WS2812B; SMD4_XL-1010RGBC_XLG
U26: MT3608B; SOT-23-6

Connections:
BAT_RAW: J1.1, Q2.2 (S), R6.1
BOOST_EN: Q1.3 (D), R4.2, U26.4 (EN)
CODON2: U7.1 (VDD), U8.4 (DIN)
CODON3: U13.1 (VDD), U14.4 (DIN)
CODON4: U19.1 (VDD), U20.4 (DIN)
CODON_END: U25.1 (VDD)
CODON_START: R1.1, U1.6 (D6/TX)
DIN_FIRST: R1.2, U2.4 (DIN)
FB: R2.2, R3.1, U26.3 (FB)
GND: C1.2, C2.2, C3.2, C4.2, C5.2, C6.2, C7.2, C8.2, C9.2, C10.2, C11.2, C12.2, C13.2, C14.2, C15.2, C16.2, C17.2, C18.2, C19.2, C20.2, C21.2, C22.2, C23.2, C24.2, C25.2, C26.2, C27.2, C28.2, C29.2, J1.2, Q1.2 (S), R3.2, R5.2, SW1.2 (B), U1.BAT_N (BAT-), U1.GND, U2.3 (VSS), U3.3 (VSS), U4.3 (VSS), U5.3 (VSS), U6.3 (VSS), U7.3 (VSS), U8.3 (VSS), U9.3 (VSS), U10.3 (VSS), U11.3 (VSS), U12.3 (VSS), U13.3 (VSS), U14.3 (VSS), U15.3 (VSS), U16.3 (VSS), U17.3 (VSS), U18.3 (VSS), U19.3 (VSS), U20.3 (VSS), U21.3 (VSS), U22.3 (VSS), U23.3 (VSS), U24.3 (VSS), U25.3 (VSS), U26.2 (GND)
unnamed: U2.1 (VDD), U3.4 (DIN)
unnamed: U3.1 (VDD), U4.4 (DIN)
unnamed: U4.1 (VDD), U5.4 (DIN)
unnamed: U5.1 (VDD), U6.4 (DIN)
unnamed: U6.1 (VDD), U7.4 (DIN)
unnamed: U8.1 (VDD), U9.4 (DIN)
unnamed: U9.1 (VDD), U10.4 (DIN)
unnamed: U10.1 (VDD), U11.4 (DIN)
unnamed: U11.1 (VDD), U12.4 (DIN)
unnamed: U12.1 (VDD), U13.4 (DIN)
unnamed: U14.1 (VDD), U15.4 (DIN)
unnamed: U15.1 (VDD), U16.4 (DIN)
unnamed: U16.1 (VDD), U17.4 (DIN)
unnamed: U17.1 (VDD), U18.4 (DIN)
unnamed: U18.1 (VDD), U19.4 (DIN)
unnamed: U20.1 (VDD), U21.4 (DIN)
unnamed: U21.1 (VDD), U22.4 (DIN)
unnamed: U22.1 (VDD), U23.4 (DIN)
unnamed: U23.1 (VDD), U24.4 (DIN)
unnamed: U24.1 (VDD), U25.4 (DIN)
POWER: C1.1, C2.1, C3.1, C4.1, C5.1, C6.1, C7.1, C8.1, C9.1, C10.1, C11.1, C12.1, C13.1, C14.1, C15.1, C16.1, C17.1, C18.1, C19.1, C20.1, C21.1, C22.1, C23.1, C24.1, C25.1, C27.1, C29.1, D1.1 (K), D2.1 (K), R2.1, U2.2 (DOUT), U3.2 (DOUT), U4.2 (DOUT), U5.2 (DOUT), U6.2 (DOUT), U7.2 (DOUT), U8.2 (DOUT), U9.2 (DOUT), U10.2 (DOUT), U11.2 (DOUT), U12.2 (DOUT), U13.2 (DOUT), U14.2 (DOUT), U15.2 (DOUT), U16.2 (DOUT), U17.2 (DOUT), U18.2 (DOUT), U19.2 (DOUT), U20.2 (DOUT), U21.2 (DOUT), U22.2 (DOUT), U23.2 (DOUT), U24.2 (DOUT), U25.2 (DOUT)
PWR_G: Q2.1 (G), R6.2, SW1.1 (A)
SW: D1.2 (A), L1.2, U26.1 (SW)
VBAT: C26.1, C28.1, L1.1, Q2.3 (D), R4.1, U1.BAT_P (BAT+), U26.5 (IN)
VUSB: D2.2 (A), Q1.1 (G), R5.1, U1.VUSB

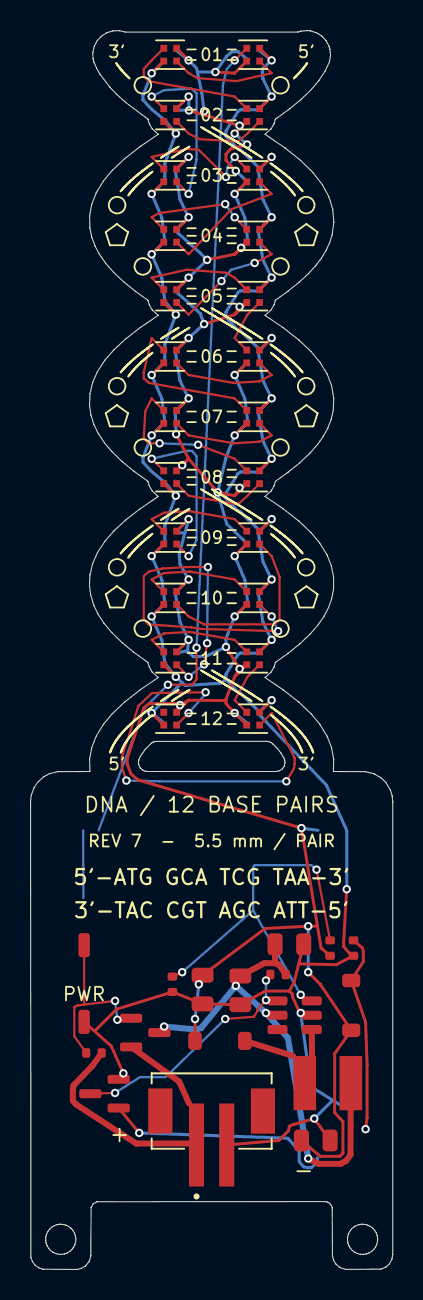
[picture p37: board dna-accesories.kicad_pcb from above]

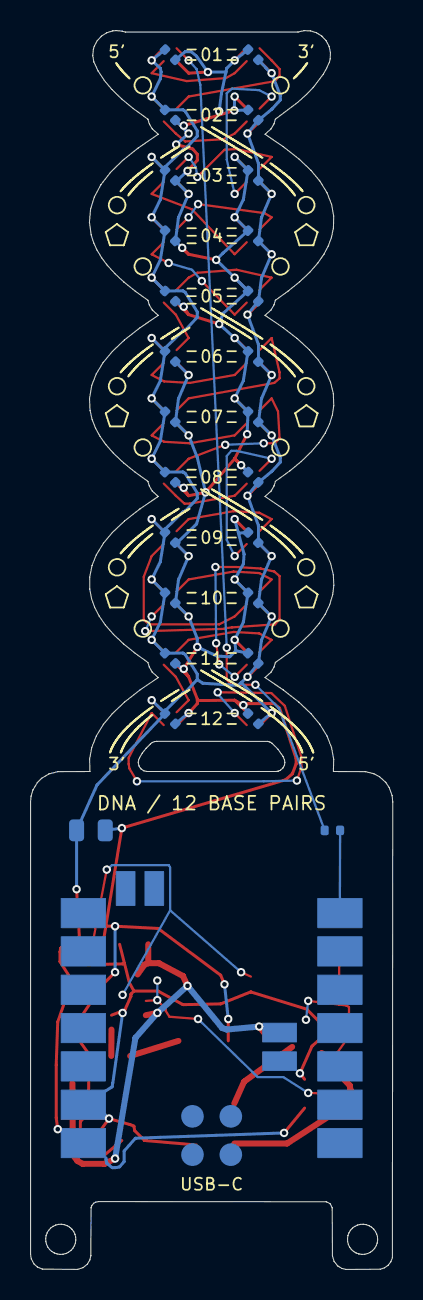
[picture p38: board dna-accesories.kicad_pcb from below]

Board: 2 copper layers, 24.0 x 82.1 mm, 68 parts (27 on the bottom side), 34 nets.
