accel-kitchen/dna-accessory-console/design/revision-01/dna-accesories.kicad_pcb

## KiCad design design/revision-01/dna-accesories.kicad_pcb (2026-11-02)

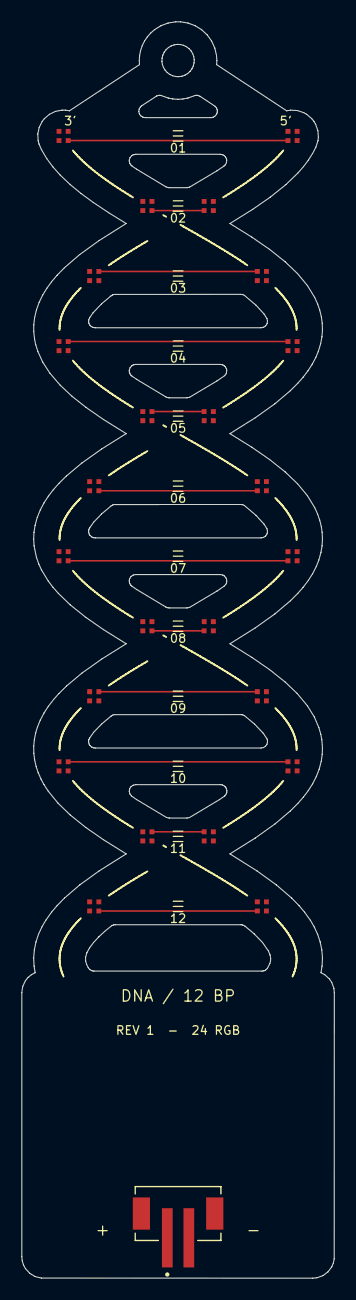
[picture p39: board design/revision-01/dna-accesories.kicad_pcb from above]

Board: 2 copper layers, 29.0 x 116.6 mm, 26 parts (1 on the bottom side), 28 nets.

Parts:
J1: B2B-PH-SM4-TB; JST_B2B-PH-SM4-TB
U1: 102010448; MODULE_102010448
U2, U3, U4, U5, U6, U7, U8, U9, U10, U11, U12, U13, U14, U15, U16, U17, U18, U19, U20, U21, U22, U23, U24, U25: XL-1010RGBC-WS2812B; SMD4_XL-1010RGBC_XLG

Connections:
CODON2: U7.2 (DOUT), U8.4 (DIN)
CODON3: U13.2 (DOUT), U14.4 (DIN)
CODON4: U19.2 (DOUT), U20.4 (DIN)
CODON_START: U1.6 (D6/TX), U2.4 (DIN)
GND: U1.GND, U2.3 (VSS), U3.3 (VSS), U4.3 (VSS), U5.3 (VSS), U6.3 (VSS), U7.3 (VSS), U8.3 (VSS), U9.3 (VSS), U10.3 (VSS), U11.3 (VSS), U12.3 (VSS), U13.3 (VSS), U14.3 (VSS), U15.3 (VSS), U16.3 (VSS), U17.3 (VSS), U18.3 (VSS), U19.3 (VSS), U20.3 (VSS), U21.3 (VSS), U22.3 (VSS), U23.3 (VSS), U24.3 (VSS), U25.3 (VSS)
unnamed: J1.1, U1.BAT_P (BAT+)
unnamed: J1.2, U1.BAT_N (BAT-)
unnamed: U2.2 (DOUT), U3.4 (DIN)
unnamed: U3.2 (DOUT), U4.4 (DIN)
unnamed: U4.2 (DOUT), U5.4 (DIN)
unnamed: U5.2 (DOUT), U6.4 (DIN)
unnamed: U6.2 (DOUT), U7.4 (DIN)
unnamed: U8.2 (DOUT), U9.4 (DIN)
unnamed: U9.2 (DOUT), U10.4 (DIN)
unnamed: U10.2 (DOUT), U11.4 (DIN)
unnamed: U11.2 (DOUT), U12.4 (DIN)
unnamed: U12.2 (DOUT), U13.4 (DIN)
unnamed: U14.2 (DOUT), U15.4 (DIN)
unnamed: U15.2 (DOUT), U16.4 (DIN)
unnamed: U16.2 (DOUT), U17.4 (DIN)
unnamed: U17.2 (DOUT), U18.4 (DIN)
unnamed: U18.2 (DOUT), U19.4 (DIN)
unnamed: U20.2 (DOUT), U21.4 (DIN)
unnamed: U21.2 (DOUT), U22.4 (DIN)
unnamed: U22.2 (DOUT), U23.4 (DIN)
unnamed: U23.2 (DOUT), U24.4 (DIN)
unnamed: U24.2 (DOUT), U25.4 (DIN)
POWER: U1.VUSB, U2.1 (VDD), U3.1 (VDD), U4.1 (VDD), U5.1 (VDD), U6.1 (VDD), U7.1 (VDD), U8.1 (VDD), U9.1 (VDD), U10.1 (VDD), U11.1 (VDD), U12.1 (VDD), U13.1 (VDD), U14.1 (VDD), U15.1 (VDD), U16.1 (VDD), U17.1 (VDD), U18.1 (VDD), U19.1 (VDD), U20.1 (VDD), U21.1 (VDD), U22.1 (VDD), U23.1 (VDD), U24.1 (VDD), U25.1 (VDD)
