accel-kitchen/dna-accessory-console/(commit log)

2026-10-29 Add DNA LED console (firmware sketch + Web Serial control page)
    - firmware/dna_console: USB-serial command sketch for the 24-LED DNA accessory
    - web: browser console (codon slots, text-to-codon, paint, frames, effects)
    - PLAN.md / README.md: design, usage, protocol, hardware check list
    The sketch has not been compiled or flashed yet.
2026-10-29 Move web files up to console/ so the page is served at /console/
    index.html, app.js, codons.js, style.css and board-data.js now live
    directly in console/. Docs, sketch comment and generator path updated.
2026-11-02 Add helix, wheel, molecules and amino acid views to DNA console
2026-11-02 Add alphabet table: pick a letter to put its codon in the selected slot
    Each of A-Z and * is a card with the codon as base tiles and the amino acid
    character. Selecting one fills the current codon slot and shows a short
    introduction of the amino acid; letters without a standard amino acid
    explain why (B, J, Z, X ambiguity codes; O and U recoded stops).
2026-11-02 Lay the board preview out from the LED coordinates
    The preview used fixed positions for the LED radius, labels and highlights,
    which only fit the old 10 mm pair pitch. Derive LED size, viewBox, brackets
    and highlights from board-data.js so a changed board design draws correctly.
2026-11-02 Track the PCB project; compact helix with corner chain holes
    Start tracking the KiCad project (board, schematic, libraries, gen/ scripts,
    design/ outputs, firmware). .gitignore now excludes only caches, installers,
    generated router runs, earlier-revision backups and fusion/ output.
    Board revision 5: helix 6 mm LED pairs at 5.2 mm pitch (29.0 x 92.4 mm),
    chain holes moved from the helix tip to the two lower collar corners
    (2.0 mm), base letters removed from the silkscreen. DRC: 0 violations,
    0 unconnected, 0 schematic parity issues. console/board-data.js regenerated.
2026-11-02 Narrow the controller collar to 24 mm; chain holes in ears below the USB-C edge
    Collar 29 -> 24 mm wide (XIAO pads need 20 mm). Two 4 mm ears reach 4.5 mm below
    the USB-C edge, 16 mm apart so the plug passes between them, each with a 2.0 mm
    chain hole. Board is now 24.0 x 96.9 mm. Re-routed: DRC 0 violations,
    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
2026-11-02 Update geometry script and router board dump for the ear holes
2026-11-02 Fold the codon slots into the board and put the stage on the paper
    - remove the codon slot cards; the four codons are now drawn next to the board
    as base tiles + amino acid name, clickable (codon / base position)
    - direct codon input moves into the inspector
    - board and 3D model drop the dark card: light PCB drawing, light 3D lighting,
    unfocused parts fade towards the page colour
2026-11-02 Make the codon wheel show which letter each codon stands for
    - larger one-letter amino acid code on every codon cell, "S・Ser" style labels
    on the outer ring, tooltips, and the letter shown big in the centre
    - wording of the wheel help text updated
2026-11-02 Split the picker into "from alphabet" and "from codon" tabs; drop text-to-codon
    - tab 1: alphabet table; tab 2: codon wheel (+ translation, bases guide)
    - the codon inspector is shared and follows the active tab
    - the wheel shows a short introduction of the hovered / selected codon
    - remove the text-to-codon panel and its code
2026-11-02 Compact DNA helix (82 mm), regenerate order data and update the LP mock-up
    Board revision 5, second step: LED pairs 5.5 mm apart at 4.0 mm pitch, 3.0 mm
    rungs, 16 mm wide helix; board 24.0 x 82.1 mm (was 29.0 x 116.6). Re-routed
    with 0.56 mm copper-to-edge: DRC 0 violations, 0 unconnected, 0 parity issues.
    - fusion/: Seeed Fusion package regenerated (gerber, BOM, centroid, assembly
    drawing, README measurements); the drawing header now takes the size from
    the board data instead of a hard-coded string.
    - lp/: 3D renders and LED overlay mapping regenerated by gen/make_lp_images.py;
    size, hole and silkscreen wording updated.
    - console/board-data.js regenerated. gen/rebuild_dna_board.py: b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
2026-11-05 Add a rev4 vs rev5 comparison page; fix the helix length in design/README
    design/comparison-rev4-rev5.html is a single self-contained page: same-scale
    3D renders (front/back), outline overlay, measured figures (size, area, helix,
    pair spacing, tracks, vias, DRC), the three changes with before/after crops,
    and trade-offs. Built by gen/compare_stats.py + gen/make_comparison.py.
    design/README.md said the helix was ~41 mm; measured: 88.1 -> 49.1 mm from tip
    to collar (the 12 pair pitches add up to 78 -> 48 mm).
2026-11-06 Review the rev5 board in review.html; archive the rev3/rev4 review
    review.html is rewritten for revision 5: board nets walked on the board itself,
    copper margins measured with strict DRC rules and compared with the Seeed Fusion
    public limits, DC voltage drop from a resistor network of the real copper,
    3D interference rerun, fusion data cross-checked (gerber, drill, BOM, centroid).
    Open items: LED power is VUSB only (no battery-only lighting), 1.0 mm web around
    the chain holes, 0.13 mm via annular ring (Fusion limit not found), battery
    connector polarity, XIAO antenna-side copper.
    - The previous review is design/review-rev3-rev4.html; build_functional_review.py
    now writes there.
    - design/R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
2026-11-06 Battery power for the LEDs: MT3608B boost with automatic USB/battery switching (rev 6)
    LED power was USB only (U1.VUSB), so the pendant did not light on a battery.
    Circuit (13 parts on the front of the collar):
    battery VBAT -> L1 -> MT3608B (U26) -> D1 -> POWER, 5.0 V = 0.6 V x (1 + 110k/15k)
    USB VUSB -> D2 -> POWER; Q1 pulls the boost EN low while USB is present (USB wins)
    C26/C28 input, C27/C29 (+ C25) output capacitors; R4 EN pull-up, R5 gate pull-down
    battery return (J1.2, U1.BAT-) tied to GND (BAT- is GND in the Seeed v1.1 schematic)
    Tools: gen/add_boost_sch.py (schematic text edit), gen/place_boost.py (placement
    search), gen/add_boost_pcb.py (footprints and nets; builds desig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
2026-11-06 Add a battery power switch (rev 7): P-MOSFET load switch driven by a small slide switch
    Small SMD slide switches are rated 50-300 mA and cannot carry the battery current (up to 0.73 A), so SW1
    (Nidec Copal CHS-01A) only switches the gate of Q2 (AO3401A). J1.1 (BAT_RAW) is Q2's source, the drain is VBAT
    (XIAO BAT+ and the boost input), R6 pulls the gate up (off). Off: the battery current is ~0 (the boost and LED
    idle current of ~19 mA stop); with USB plugged in the battery only charges to ~3.5 V through the body diode.
    - schematic: J1.1 / U1.BAT+ wires cut, labels BAT_RAW / VBAT, parts Q2 R6 SW1 (68 parts)
    - board: 16 power parts re-placed and re-routed (seed 61), DRC 0/0/0, min clearance 0.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
